sinara-hw/VHF_Amp/Project Outputs for VHF_AMP/Report Board Stack/VHF_AMP.xls

Board Stack Report
Stack Up |  | Layer Stack
Layer | Board Layer Stack | Name | Material | Thickness | Constant
1 |  | TopPaste
2 |  | Top Overlay
3 |  | Top Solder | SM-001 | 1,00mil | 4
4 |  | Top Layer | Copper | 1,38mil
5 |  | Dielectric 1 | PP-017 | 7,09mil | 4,3
6 |  | Dielectric 2 | PP-017 | 7,09mil | 4,3
7 |  | Int1 (GND) | Copper | 1,38mil
8 |  | Dielectric 3 | Core-039 | 27,95mil | 4,8
9 |  | Int2 (PWR) | Copper | 1,38mil
10 |  | Dielectric 4 | PP-017 | 7,09mil | 4,3
11 |  | Dielectric 5 | PP-017 | 7,09mil | 4,3
12 |  | Bottom Layer | Copper | 1,38mil
13 |  | Bottom Solder | SM-001 | 1,00mil | 4
14 |  | Bottom Overlay
15 |  | BottomPaste
 | Height : 63,81mil
