sinara-hw/VHF_Amp/Project Outputs for VHF_AMP/BOM/Bill of Materials-VHF_AMP(std).xlsx

Comment | Description | Designator | Footprint | Manufacturer | Manufacturer Part Number | Manufacturer1 ComponentHeight | Manufacturer1 Example | Manufacturer1 Part Number | Part Description | Part Number | Quantity
22nF | Non-polarised capacitor | C1, C72 | CAPC2012X135N | GENERIC | CC0805_22NF_50V_10%_X7R | 1.35mm | PHYCOMP | 223858615641 | SMD Multilayer Chip Ceramic Capacitor | CC0805_22NF_50V_10%_X7R | 2
10uF | Non-polarised capacitor | C2, C11, C12, C26, C27, C29, C42, C63 | CAPC3216X140N | GENERIC | CC1206_10UF_10V_10%_X7R | 1.8mm | KEMET | C1206C106K8RAC | SMD Multilayer Chip Ceramic Capacitor | CC1206_10UF_10V_10%_X7R | 8
10nF | Non-polarised capacitor | C3, C15, C18, C30, C40, C41, C53_VHF_FWD_RFD, C53_VHF_REV_RFD | CAPC1005X55N | GENERIC | CC0402_10NF_16V_10%_X7R, CC0402_10NF_25V_10%_X7R | 0.55mm | PHYCOMP, TDK | 223878715636, C1005X7R1E103KT | SMD Multilayer Chip Ceramic Capacitor | CC0402_10NF_16V_10%_X7R, CC0402_10NF_25V_10%_X7R | 8
100nF | Non-polarised capacitor | C4, C44, C47, C66, C73, C84 | CAPC3216X140N | GENERIC | CC1206_100NF_100V_10%_X7R | 1.25mm | PHYCOMP | 222260115649 | SMD Multilayer Chip Ceramic Capacitor | CC1206_100NF_100V_10%_X7R | 6
10nF | Non-polarised capacitor | C5, C6, C7, C9, C93, C95, C96, C100, C155, C156, C157, C159 | CAPC1608X87N | GENERIC | CC0603_10NF_50V_10%_X7R | 0.87mm | PHYCOMP | 223858615636 | SMD Multilayer Chip Ceramic Capacitor | CC0603_10NF_50V_10%_X7R | 12
220pF | Non-polarised capacitor | C8, C39, C74, C78 | CAPC2012X135N | GENERIC | CC0805_220PF_50V_5%_C0G | 0.88mm | KEMET | C0805C151J5GACTU | SMD Multilayer Chip Ceramic Capacitor | CC0805_220PF_50V_5%_C0G | 4
100nF | Non-polarised capacitor | C10, C25, C32, C34, C36, C55_VHF_FWD_RFD, C55_VHF_REV_RFD, C56_VHF_FWD_RFD, C56_VHF_REV_RFD, C57_VHF_FWD_RFD, C57_VHF_REV_RFD, C58_VHF_FWD_RFD, C58_VHF_REV_RFD, C60_VHF_FWD_RFD, C60_VHF_REV_RFD, C61_VHF_FWD_RFD, C61_VHF_REV_RFD, C62, C64, C65, C67, C89, C108, C110, C139, C141, C142, C150, C152, C153, C161, C162, C245_VHF_FWD_RFD, C245_VHF_REV_RFD | CAPC1005X55N | GENERIC | CC0402_100NF_16V_10%_X5R, CC0402_100NF_50V_10%_X7R | 0.55mm | MURATA | GRM155R61C104KA88D, GRM155R71H104KE14D | SMD Multilayer Chip Ceramic Capacitor | CC0402_100NF_16V_10%_X5R, CC0402_100NF_50V_10%_X7R | 34
22uF | Non-polarised capacitor | C13, C14 | CAPC3225X140N | GENERIC | CC1210_22UF_25V_20%_X7R | 1.4mm | KEMET | C1210C226M3RACTU | SMD Multilayer Chip Ceramic Capacitor | CC1210_22UF_25V_20%_X7R | 2
220pF | Non-polarised capacitor | C16, C17, C20, C21 | CAPC1005X55N | GENERIC | CC0402_220PF_50V_5%_C0G | 0.55mm | KEMET | C0402C221J5GACTU | SMD Multilayer Chip Ceramic Capacitor | CC0402_220PF_50V_5%_C0G | 4
0.5pF | Non-polarised capacitor | C19 | CAPC1005X50N | AVX | 04023J0R5ABSTR |  |  |  | Thin-Film Chip Capacitor for RF Signal and Power Applications, Accu-P Series | CC0402_0.5PF_25V_0.05PF_AVX_04023J0R5ABSTR | 1
100nF | Non-polarised capacitor | C22 | CAPC1608X87N | GENERIC | CC0603_100NF_50V_10%_X7R | 0.87mm | PHYCOMP | 223858615649 | SMD Multilayer Chip Ceramic Capacitor | CC0603_100NF_50V_10%_X7R | 1
10uF | Non-polarised capacitor | C23, C24 | CAPC3225X270N | GENERIC | CC1210_10UF_25V_10%_X7R | 2.7mm | KEMET | C1210C106K4RACTU | SMD Multilayer Chip Ceramic Capacitor | CC1210_10UF_25V_10%_X7R | 2
1uF | Non-polarised capacitor | C28, C68, C77, C97, C101, C112, C113, C135, C137 | CAPC1608X87N | GENERIC | CC0603_1UF_16V_10%_X7R, CC0603_1UF_25V_10%_X7R | 0.9mm | YAGEO PHYCOMP, MURATA | 223878615663, GRM188R71E105KA12D | SMD Multilayer Chip Ceramic Capacitor | CC0603_1UF_16V_10%_X7R, CC0603_1UF_25V_10%_X7R | 9
10uF | Non-polarised capacitor | C31, C48, C70, C91, C92, C94, C115, C116, C117, C123, C124, C125, C126, C127, C128, C145, C146, C147, C148 | CAPC_TDK_CKG45N | TDK | CKG45NX7S2A106M500JH |  |  |  | Multilayer Ceramic Chip Capacitor - Stacked Cap, CKG45N Series | CC1812_10UF_100V_20%_X7S_TDK_CKG45N | 19
22uF | Non-polarised capacitor | C33, C35, C37, C38, C107, C114, C138, C149 | CAPC3216X180N | TDK | C3216JB1V226M160AC |  |  |  | SMD Multilayer Chip Ceramic Capacitor | CC1206_22UF_35V_20%_JB_TDK_C3216JB1V226M160AC | 8
1nF | Non-polarised capacitor | C43, C46, C50, C83, C86, C87, C98 | CAPC2012X135N | GENERIC | CC0805_1NF_50V_5%_C0G | 0.88mm | KEMET | C0805C102J5GACTU | SMD Multilayer Chip Ceramic Capacitor | CC0805_1NF_50V_5%_C0G | 7
10uF | Non-polarised capacitor | C45, C85 | CAPC3225X280N | TAIYO YUDEN | UMK325AB7106KMHP |  |  |  | SMD Multilayer Chip Ceramic Capacitor (High Dielectric Type) for Automotive / Industrial Applications | CC1210_10UF_50V_10%_X7R_YUDEN_UMK325AB7106KMHP | 2
100nF | Non-polarised capacitor | C49, C71, C88 | CAPC2012X135N | GENERIC | CC0805_100NF_50V_10%_X7R | 1mm | TDK | C2012X7R1H104K085AA | SMD Multilayer Chip Ceramic Capacitor | CC0805_100NF_50V_10%_X7R | 3
100pF | Non-polarised capacitor | C51_VHF_FWD_RFD, C51_VHF_REV_RFD, C59_VHF_FWD_RFD, C59_VHF_REV_RFD | CAPC1005X55N | GENERIC | CC0402_100PF_50V_5%_C0G | 0.55mm | KEMET | C0402C101J5GACTU | SMD Multilayer Chip Ceramic Capacitor | CC0402_100PF_50V_5%_C0G | 4
2.2nF | Non-polarised capacitor | C52_VHF_FWD_RFD, C52_VHF_REV_RFD | CAPC1608X87N | GENERIC | CC0603_2.2NF_50V_5%_C0G | 0.9mm | TDK | C1608C0G1H222J080AA | SMD Multilayer Chip Ceramic Capacitor | CC0603_2.2NF_50V_5%_C0G | 2
1nF | Non-polarised capacitor | C54_VHF_FWD_RFD, C54_VHF_REV_RFD | CAPC1005X55N | GENERIC | CC0402_1NF_50V_10%_X7R | 0.55mm | PHYCOMP | 223858715623 | SMD Multilayer Chip Ceramic Capacitor | CC0402_1NF_50V_10%_X7R | 2
1uF | Non-polarised capacitor | C69, C75, C76, C82, C99, C103, C105, C106, C109, C134, C140, C143, C144, C151 | CAPC1005X55N | GENERIC | CC0402_1UF_16V_10%_X5R | 0.55mm | TDK | C1005X5R1C105KT | SMD Multilayer Chip Ceramic Capacitor | CC0402_1UF_16V_10%_X5R | 14
10uF | Non-polarised capacitor | C79, C80, C81 | CAPC2012X95N | GENERIC | CC0805_10UF_25V_10%_X5R | 0.95mm | MURATA | GRM219R61E106KA12D | SMD Multilayer Chip Ceramic Capacitor | CC0805_10UF_25V_10%_X5R | 3
4.7uF | Non-polarised capacitor | C90 | CAPC1709X95N | GENERIC | CC0603_4.7UF_16V_10%_X5R | 0.95mm | TAIYO YUDEN | EMK107ABJ475KA-T | SMD Multilayer Chip Ceramic Capacitor | CC0603_4.7UF_16V_10%_X5R | 1
4.7uF | Polarised capacitor | C102 | CAPMP3216X180N | AVX | TPSA475K010T1400 |  |  |  | Low ESR 1R4 Automotive Solid Tantalum Chip Capacitor | CTE3216-18_4.7UF_10V_10%_AVX_TPSA475K010T1400 | 1
Undefined | Non-polarised capacitor | C111, C122, C133, C136 | CAPC1608X90N | Undefined | CC0603_NO-VALUE | 0.9mm |  |  | Reserved Footprint For 0603(1608) Chip Ceramic Capacitor | CC0603_NO-VALUE | 4
2.2uF | Non-polarised capacitor | C118, C119, C120, C121, C129, C130, C131, C132 | CAPC3216X180N | GENERIC | CC1206_2.2uF_50V_10%_X7R | 1.8mm | KEMET | C1206C225K5RACTU | SMD Multilayer Chip Ceramic Capacitor | CC1206_2.2UF_50V_10%_X7R | 8
1uF | Non-polarised capacitor | C154 | CAPC2012X110N | GENERIC | CC0805_1UF_50V_10%_X7R | 1.1mm | KEMET | C0805C105K5RACTU | SMD Multilayer Chip Ceramic Capacitor | CC0805_1UF_50V_10%_X7R | 1
Undefined | Non-polarised capacitor | C158, C160 | CAPC2012X135N | Undefined | CC0805_NO-VALUE | 1.35mm |  |  | Reserved Footprint For 0805(2012) Chip Ceramic Capacitor | CC0805_NO-VALUE | 2
SMBJ12A | Zener Diode | D1 | DIOM5336X265N | FAIRCHILD SEMICONDUCTOR | SMBJ12A |  |  |  | Uni-Directional Transient Voltage Suppressor Diode | SMBJ12A | 1
BAT165 | Schottky Diode | D2 | SOD2512X110N | INFINEON | BAT165 |  |  |  | Medium Power AF Schottky Diode | BAT165 | 1
PESD3V3S4UD | Quad Common Anode ESD Protection Diodes (30kV) | D3, D4 | SOT95P280X110-6N | NXP SEMICONDUCTORS | PESD3V3S4UD |  |  |  | Quad Common Anode ESD Protection Diodes (30kV) | PESD3V3S4UD | 2
PRTR5V0U2X | Ultra Low Capacitance Double Rail-to-Rail ESD Protection Diode | D6 | SOT190P230X110-4N | NXP SEMICONDUCTORS | PRTR5V0U2X |  |  |  | Ultra Low Capacitance (1pF) Double Rail-to-Rail ESD Protection Diode (8kV) | PRTR5V0U2X | 1
PMEG6020ER | Schottky Diode | D8 | SODFL3517X110N | NXP SEMICONDUCTORS | PMEG6020ER |  |  |  | MEGA Schottky Barrier Rectifier | PMEG6020ER | 1
220R@100MHz |  | FB2_VHF_FWD_RFD, FB2_VHF_REV_RFD | INDC1005X55N | MURATA | BLM15HB221SN1 |  |  |  | SMD EMIFIL Suppression Chip Ferrite Bead | IND0402_MURATA_BLM15HB221SN1 | 2
10A/50VDC | Block Type EMIFIL (LC Combined) | FL1 | FIL_MURATA_BNX02 | MURATA | BNX022-01L |  |  |  | Block Type EMIFIL (LC Combined) SMD Type, BNX02* Series | FIL_MURATA_BNX022-01L | 1
MERA-7456 | Dual Differential Inputs and Complementary TTL outputs | IC1 | MINI-CIRCUITS_DL1020 | MINI-CIRCUITS | MERA-7456 |  |  |  | DC-1GHz, Dual Matched MMIC Amplifier | MERA-7456 | 1
FIN1028MX | 3.3V LVDS 2-Bit High-Speed Differential Reciever | IC2, IC13, IC15 | SOIC127P600X175-8N | ON Semiconductor | FIN1028MX |  |  |  | 3.3V LVDS 2-Bit High-Speed Differential Reciever | FIN1028MX | 3
LT1963EQ#PBF | 1.5A, Fast Transient Response Adjustable LDO Regulators | IC3 | TO170P1394X457-6N-R900X1060 | LINEAR TECHNOLOGY | LT1963EQ#PBF |  |  |  | 1.5A, 1.21V to 20V, Fast Transient Response, Adjustable LDO Regulator | LT1963EQ#PBF | 1
FIN1027AMX | 3.3V LVDS, 2-Bit, High-Speed, Differential Driver | IC4 | SOIC127P600X175-8N | ON Semiconductor | FIN1027AMX |  |  |  | 3.3V LVDS, 2-Bit, High-Speed, Differential Driver | FIN1027AMX | 1
TPS62148RGX | 3V-17V 2A Step-Down Converter, High Accuracy, With DCS-Control | IC5 | TEXAS_RGX0011A | TEXAS INSTRUMENTS | TPS62148RGX |  |  |  | 3V-17V 2A Step-Down Converter, High Accuracy, With DCS-Control | TPS62148RGX | 1
TPS7A4700RGWT | Low Noise (3uVrms), 1A, High Voltage Low-Dropout Linear Regulator | IC6, IC25 | QFN65P500X500X100-21N-S325 | TEXAS INSTRUMENTS | TPS7A4700RGW |  |  |  | 1.4V to 19.1V, 1A, Low Noise (3.5uVrms), Low-Dropout Linear Regulator | TPS7A4700RGWT | 2
MPGA-152 | Dual Differential Inputs and Complementary TTL outputs | IC7 | QFN50P400X400X100-25N-S265 | MINI-CIRCUITS | MPGA-152 |  |  |  | 30GHz to 1500MHz, 50 Ohm, Low Noise, High IP3, Monolithic Amplifier | MPGA-152 | 1
MAX1329BETL+ | 12-/16-Bit DAS with ADC, DACs, DPIOs, APIOs, Reference, Voltage Monitors, and Temp Sensor | IC8, IC19 | QFN50P600X600X80-41N-S425 | MAXIM | MAX1329BETL |  |  |  | 12-/16-Bit DAS with ADC, DACs, DPIOs, APIOs, Reference, Voltage Monitors, and Temp Sensor | MAX1329BETL+ | 2
ADL5904ACPZN-R7 | DC to 6 GHz, 45 dB TruPwr Detector With Envelope Threshold Detection | IC9_VHF_FWD_RFD, IC9_VHF_REV_RFD | QFN50P300X300X80-17N-S175 | ANALOG DEVICES | ADL5904ACPZN-R7 |  |  |  | DC to 6 GHz, 45 dB TruPwr Detector With Envelope Threshold Detection | ADL5904ACPZN-R7 | 2
ADCMP600BRJZ-R2 | Rail-to-Rail, Very Fast, 2.5 V to 5.5 V Single-Supply TTL/CMOS Comparator | IC10_VHF_FWD_RFD, IC10_VHF_REV_RFD | SOT95P280X145-5N | ANALOG DEVICES | ADCMP600BRJZ-R2 |  |  |  | Rail-to-Rail, Very Fast, 2.5 V to 5.5 V Single-Supply TTL/CMOS Comparator | ADCMP600BRJZ-R2 | 2
SN74LVC112APWR | Dual Negative-Edge-Triggered J-K Flip-Flop With Clear And Preset | IC11_VHF_FWD_RFD, IC11_VHF_REV_RFD | SOP65P640X120-16N | TEXAS INSTRUMENTS | SN74LVC112APWR |  |  |  | Dual Negative-Edge-Triggered J-K Flip-Flops With Clear and Preset | SN74LVC112APWR | 2
MCP6291T-E/OT | Operational Amplifier | IC12_VHF_FWD_RFD, IC12_VHF_REV_RFD, IC17_VHF_FWD_RFD, IC17_VHF_REV_RFD | SOT95P270X145-5N | MICROCHIP TECHNOLOGY | MCP6291T-E/OT |  |  |  | 1.0mA, 10 MHz Rail-to-Rail Operational Amplifier | MCP6291T-E/OT | 4
74HC4066PW |  | IC14, IC32 | SOP65P640X110-14N | NXP SEMICONDUCTORS | 74HC4066PW |  |  |  | Quad Single-Pole Single-Throw Analog Switch | 74HC4066PW | 2
24AA02E48T-I/OT | 1.7V-5.5V, 2K I2C Serial EEPROM With EUI-48 Node Identity | IC16 | SOT95P280X145-5N | MICROCHIP TECHNOLOGY | 24AA02E48T-I/OT |  |  |  | 1.7V-5.5V, 2K I2C Serial EEPROM With EUI-48 Node Identity | 24AA02E48T-I/OT | 1
JSW2-63DR+ | SPDT RF Switch, 50 Ohm, 5 to 6000MHz, High Power 3W | IC18 | MINI-CIRCUITS_MT1818 | MINI-CIRCUITS | JSW2-63DR+ |  |  |  | SPDT RF Switch, 50 Ohms, 5 to 6000MHz, High Power 3W | JSW2-63DR+ | 1
AD8397ARDZ | Dual Operational Amplifier With Exposed Pad | IC20, IC23 | SOIC127P600X175-9N-R241X309 | ANALOG DEVICES | AD8397ARDZ |  |  |  | Rail-to-Rail, High Output Current Amplifier | AD8397ARDZ | 2
LTM8056IY#PBF | 58VIN, 48VOUT Buck-Boost µModule Regulator | IC21, IC22 | BGA121C127P11X11_1500X1500X512 | LINEAR TECHNOLOGY | LTM8056IY#PBF |  |  |  | 58VIN, 48VOUT Buck-Boost µModule Regulator | LTM8056IY#PBF | 2
SN74LVC1G32DBVR | Single 2-Input Positive-OR Gate | IC24_VHF_FWD_RFD, IC24_VHF_REV_RFD | SOT95P280X145-5N | TEXAS INSTRUMENTS | SN74LVC1G32DBVR |  |  |  | Single 2-Input Positive-OR Gate | SN74LVC1G32DBVR | 2
LM75AIMM/NOPB | Digital Temperature Sensor and Thermal Watchdog with Two-Wire Interface | IC26, IC27 | SOP65P490X109-8N | TEXAS INSTRUMENTS | LM75AIMM/NOPB |  |  |  | -25° to +100°C ±2°C Digital Temperature Sensor and Thermal Watchdog with Two-Wire Interface | LM75AIMM/NOPB | 2
MAX6033AAUT25#TG16 | Ultra-High-Precision Voltage References | IC28 | SOT95P280X145-6N | MAXIM | MAX6033AAUT25#TG16 |  |  |  | 2.5V, 15mA, Ultra-High-Precision Voltage References | MAX6033AAUT25#TG16 | 1
74LVC1GU04GW | Single Inverter Buffer | IC29, IC38 | SOT65P212X110-5N | NXP SEMICONDUCTORS | 74LVC1GU04GW |  |  |  | Inverter | 74LVC1GU04GW | 2
LD1117DT33CTR | 3-Terminal Regulator 1=GND 2=IN 3=OUT | IC30, IC31 | TO228P972X240-3N-R540X510 | ST MICROELECTRONICS | LD1117DT33CTR |  |  |  | 3.3V 800mA Low drop fixed and adjustable positive voltage regulators | LD1117DT33CTR | 2
MIC5219-3.3YM5 | 500mA Peak Output LDO Regulator | IC33 | SOT95P280X145-5N | MICROCHIP TECHNOLOGY | MIC5219-3.3YM5 |  |  |  | 3.3V 500mA Peak Output Low Drop-Out (LDO) Regulator | MIC5219-3.3YM5 | 1
SYDC-20-62HP+ | 50Ohm, 10 to 540MHz, 25W, 20dB Bi-Directional Coupler | IC34 | MINI-CIRCUITS_AH202-1 | MINI-CIRCUITS | SYDC-20-62HP+ |  |  |  | 50Ohm, 10 to 540MHz, 25W, 20dB Bi-Directional Coupler | SYDC-20-62HP+ | 1
TLC555ID | LinCMOS Timer | IC35 | SOIC127P600X175-8N | TEXAS INSTRUMENTS | TLC555ID |  |  |  | LinCMOS Timer | TLC555ID | 1
INA286AQDRQ1 | 80V, Bi-Directional, Low-/High-Side, Voltage Output Current Sense Amplifier | IC36, IC37 | SOIC127P600X175-8N | TEXAS INSTRUMENTS | INA286AQDRQ1 |  |  |  | 80V, Bi-Directional, Low-/High-Side, Voltage Output Current Sense Amplifier (Automotive Grade) | INA286AQDRQ1 | 2
SMA | 50 Ohm Through Hole SMA Right Angle PCB Jack | J1, J2 | DELOCK_65848 | DELOCK | 5848 (4043619658480) |  |  |  | 50 Ohm Through Hole SMA Right Angle PCB Jack | DELOCK_65848 | 2
MCX |  | J3 | AMPHENOL_919-383J-51A | AMPHENOL | 919-383J-51A |  |  |  | 50 Ohm, RF Connector, MCX Right Angle PCB Receptacle Jack | AMPHENOL_919-383J-51A | 1
Mini-Fit Jr.™ | Connector 4 Male | J7 | MOLEX_39-30-0040 | MOLEX | 39-30-0040 |  |  |  | 4.20mm (.165") Pitch Mini-Fit Jr. Header, Dual Row, Right Angle with Snap-in Plastic Peg PCB Lock, 4 Circuits | MOLEX_39-30-0040 | 1
Jack | 2.5 mm Center Pin, 5A, 48V, Right Angle, Through Hole, , DC Power Jack Connector | J8 | SWITCHCRAFT_712RA | SWITCHCRAFT | 712RA |  |  |  | 2.5 mm Center Pin, 5A, 48VDC, Right Angle, Through Hole, Locking Power Jack Connector (Threaded Bushings) | SWITCHCRAFT_712RA | 1
 | Connector 30 Male | J9 | 3M_N2530-6002RB | 3M | N2530-6002RB |  |  |  | 30 Contacts - Straight .100'' x .100'' Low Profile Four-Wall Header, 2500 Series | 3M_N2530-6002RB | 1
KK® | Connector 2 Male | J11 | MOLEX_22-04-1021 | MOLEX | 22-04-1021 |  |  |  | 2.5mm (.100") Pitch KK® Wire-to-Board Header, Vertical, with Friction Lock, 2 Circuits, Tin (Sn) Plating | MOLEX_22-04-1021 | 1
P1 | 72 Contacts Header, 6 Columns, 4 Pairs per Column | J13 | AMPHENOL_10052825-101LF | AMPHENOL | 10052825-101LF |  |  |  | 72 Contacts, 2mm Pitch, 6 Columns, 4 Pairs per Column, 4 Walls, Right Angle Header | AMPHENOL_10052825-101LF | 1
120R@100MHz |  | L1, L12 | INDC1005X55N | MURATA | BLM15PX121SN1D |  |  |  | SMD EMIFIL Chip Ferrite Bead | IND0402_MURATA_BLM15PX121SN1D | 2
390nH@100MHz | Inductor | L2, L3, L4, L5 | IND_COILCRAFT_0805HP | COILCRAFT | 0805HP-391XGR |  |  |  | Chip Inductor | IND0805_COILCRAFT_0805HP-391XGR | 4
1000R@100MHz |  | L6 | INDC1608X95N | MURATA | BLM18HE102SN1 |  |  |  | SMD EMIFIL Suppression Chip Ferrite Bead | IND0603_MURATA_BLM18HE102SN1 | 1
1uH | Inductor | L7, L11 | INDC2620X100N | WURTH ELEKTRONIK | 74479787210B |  |  |  | Power Multilayer Inductor (WE-PMI Series) | IND1008_1UH_20%_WURTH_74479787210B | 2
1.5uH | Inductor With Core | L8, L9, L10 | IND_TDK_SPM6530 | TDK | SPM6530T-1R5M100 |  |  |  | SMD Inductor for Power Circuits (Wound Metal), SPM Series | IND_1.5UH_20%_TDK_SPM6530 | 3
100nH | Inductor | L13, L14 | IND_COILCRAFT_1812SMS | COILCRAFT | 1812SMS-R10JLC |  |  |  | SMD Midi Spring Air Core Inductor | IND_100NH_5%_COILCRAFT_1812SMS-R10JLC | 2
1uH | Inductor | L15, L16 | IND_BOURNS_SRN3015 | BOURNS | SRN3015-1R0Y |  |  |  | Semi-Shielded SMD Power Inductor | IND_1UH_30%_BOURNS_SRN3015 | 2
Green | LED Green 1C 2A | LD1, LD2, LD3, LD4, LD5, LD6, LD7, LD8_VHF_FWD_RFD, LD8_VHF_REV_RFD, LD9, LD11 | LED_KINGBRIGHT_KPH-1608CGCK | KINGBRIGHT | KPH-1608CGCK |  |  |  | SMD Green LED, Case 1.6mmX0.8mm(0603), 0.65mm Thickness | LED_KINGBRIGHT_KPH-1608CGCK | 11
Red | LED Red 1C 2A | LD10 | LED_AVAGO_HSMC-C120 | AVAGO TECHNOLOGIES | HSMC-C120 |  |  |  | High Performance Right Angle Chip Red LED | LED_AVAGO_HSMC-C120 | 1
10k | Trimming Potentiometer | P1, P2 | TRIM_BOURNS_3224W | BOURNS | 3224W-1-103E |  |  |  | 12 Turns SMD Trimpot® Trimming Potentiometer (Top Adjust) | TRIM_12T_10K_BOURNS_3224W-1-103E | 2
Switch | Push-Button Switch SPDT | PB1, PB2 | SW_C&K_PCM12SMTR | C&K | PCM12SMTR |  |  |  | SPDT, Right Angled Ultraminiature Surface Mount Slide Switches, C&K PCM Series | SW_C&K_PCM12SMTR | 2
Push Button | Push-Button Switch SPDT | PB3 | PB_TYCO_1-1825027-1 | TYCO ELECTRONICS | 1-1825027-1 |  |  |  | Right Angle Micro Miniature Tactile Pushbutton Switch, Round Actuator Length = 5.74mm, FSMRAJ Series | PB_TYCO_1-1825027-1 | 1
51 | Resistor - 1% | R1, R2 | RESC5025X70N | BOURNS | CRM2010-FX-51R0ELF |  |  |  | Power Thick Film Chip Resistor | R2010_51R_1%_1W_100PPM_BOURNS_CRM | 2
0 | Resistor | R3, R4, R5, R6, R7, R8, R9, R24_VHF_FWD_RFD, R24_VHF_REV_RFD, R92, R105, R151, R154, R235, R236, R241, R242, R243, R247, R248 | RESC1005X40N | GENERIC | R0402_0R_JUMPER | 0.4mm | YAGEO PHYCOMP | 232270591001L | 1A (0.05R Max DC Resistance) Zero Ohm Jumper | R0402_0R_JUMPER | 20
330 | Resistor - 1% | R10, R15 | RESC2012X60N | GENERIC | R0805_330R_1%_0.125W_100PPM | 0.6mm | NIC COMPONENT | NRC10F3300TRF | General Purpose Thick Film Chip Resistor | R0805_330R_1%_0.125W_100PPM | 2
2R7 | Resistor - 1% | R11, R18 | RESC2012X60N | GENERIC | R0805_2R7_1%_0.125W_200PPM | 0.65mm | YAGEO PHYCOMP | 232273462708L or RC0805FR-072R7L | General Purpose Thick Film Chip Resistor | R0805_2R7_1%_0.125W_200PPM | 2
9R1 | Resistor - 1% | R12, R19 | RESC2012X60N | GENERIC | R0805_9R1_1%_0.125W_200PPM | 0.65mm | YAGEO PHYCOMP | 232273469108L or RC0805FR-079R1L | General Purpose Thick Film Chip Resistor | R0805_9R1_1%_0.125W_200PPM | 2
22 | Resistor - 1% | R13, R20 | RESC2012X60N | GENERIC | R0805_22R_1%_0.125W_100PPM | 0.6mm | NIC COMPONENT | NRC10F22R0TRF | General Purpose Thick Film Chip Resistor | R0805_22R_1%_0.125W_100PPM | 2
33 | Resistor - 1% | R14, R21 | RESC2012X60N | GENERIC | R0805_33R_1%_0.125W_100PPM | 0.6mm | NIC COMPONENT | NRC10F33R0TRF | General Purpose Thick Film Chip Resistor | R0805_33R_1%_0.125W_100PPM | 2
100 | Resistor - 1% | R16, R34, R35, R36, R37, R38, R39, R44, R45, R62, R80, R82, R158, R169 | RESC1005X40N | GENERIC | R0402_100R_1%_0.0625W_100PPM | 0.4mm | YAGEO PHYCOMP | 232270671001L | General Purpose Thick Film Chip Resistor | R0402_100R_1%_0.0625W_100PPM | 14
47k | Resistor - 1% | R17 | RESC1608X55N | GENERIC | R0603_47K_1%_0.1W_100PPM | 0.55mm | NIC COMPONENT | NRC06F4702TRF | General Purpose Thick Film Chip Resistor | R0603_47K_1%_0.1W_100PPM | 1
0 | Resistor | R22_VHF_FWD_RFD, R22_VHF_REV_RFD, R25_VHF_FWD_RFD, R25_VHF_REV_RFD, R40, R41, R48, R49, R66, R71, R76, R83, R84, R96, R99, R114, R115, R116, R117, R118, R119, R126, R129, R130, R131, R132, R133, R135, R136, R157, R159, R160, R164, R167, R168, R182, R183 | RESC1608X55N | GENERIC | R0603_0R_JUMPER | 0.55mm | NIC COMPONENT | NRC06Z0 | 1A (0.05R Max DC Resistance) Zero Ohm Jumper | R0603_0R_JUMPER | 37
1k | Resistor - 1% | R23_VHF_FWD_RFD, R23_VHF_REV_RFD, R47, R156, R161, R162, R170, R172, R173, R174, R175, R176, R177, R181 | RESC1005X40N | GENERIC | R0402_1K_1%_0.0625W_100PPM | 0.4mm | YAGEO PHYCOMP | 232270671002L | General Purpose Thick Film Chip Resistor | R0402_1K_1%_0.0625W_100PPM | 14
22k | Resistor - 1% | R26, R58, R60 | RESC1005X40N | GENERIC | R0402_22K_1%_0.0625W_100PPM | 0.4mm | YAGEO PHYCOMP | 232270672203L | General Purpose Thick Film Chip Resistor | R0402_22K_1%_0.0625W_100PPM | 3
82 | Resistor - 1% | R27_VHF_FWD_RFD, R27_VHF_REV_RFD | RESC1608X55N | GENERIC | R0603_82R_1%_0.1W_100PPM | 0.55mm | NIC COMPONENT | NRC06F82R0TRF | General Purpose Thick Film Chip Resistor | R0603_82R_1%_0.1W_100PPM | 2
56k | Resistor - 1% | R28 | RESC1608X55N | GENERIC | R0603_56K_1%_0.1W_100PPM | 0.55mm | NIC COMPONENT | NRC06F5602TRF | General Purpose Thick Film Chip Resistor | R0603_56K_1%_0.1W_100PPM | 1
1 | Resistor - 1% | R29, R63 | RESC1005X40N | GENERIC | R0402_1R_1%_0.0625W_200PPM | 0.4mm | YAGEO PHYCOMP | 232270671008L | General Purpose Thick Film Chip Resistor | R0402_1R_1%_0.0625W_200PPM | 2
8k2 | Resistor - 1% | R30 | RESC1608X55N | GENERIC | R0603_8K2_1%_0.1W_100PPM | 0.55mm | NIC COMPONENT | NRC06F8201TRF | General Purpose Thick Film Chip Resistor | R0603_8K2_1%_0.1W_100PPM | 1
3R9 | Resistor - 1% | R31_VHF_FWD_RFD, R31_VHF_REV_RFD | RESC1005X40N | GENERIC | R0402_3R9_1%_0.0625W_200PPM | 0.4mm | YAGEO PHYCOMP | 232270673908L | General Purpose Thick Film Chip Resistor | R0402_3R9_1%_0.0625W_200PPM | 2
10k | Resistor - 1% | R32_VHF_FWD_RFD, R32_VHF_REV_RFD, R46, R61, R72, R145, R148, R149, R153, R155, R171, R179, R218 | RESC1005X40N | GENERIC | R0402_10K_1%_0.0625W_100PPM, R0402_1K_1%_0.0625W_100PPM | 0.4mm | YAGEO PHYCOMP | 232270671003L, 232270671002L | General Purpose Thick Film Chip Resistor | R0402_10K_1%_0.0625W_100PPM, R0402_1K_1%_0.0625W_100PPM | 13
20k | Resistor - 1% | R33_VHF_FWD_RFD, R33_VHF_REV_RFD | RESC1005X40N | GENERIC | R0402_20K_1%_0.0625W_100PPM | 0.4mm | YAGEO PHYCOMP | 232270672003L | General Purpose Thick Film Chip Resistor | R0402_20K_1%_0.0625W_100PPM | 2
64k9 | Resistor - 0.1% | R42 | RESC1608X55N | GENERIC | R0603_64K9_0.1%_0.063W_10PPM | 0.5mm | TYCO HOLSWORTHY | RN73C1J64K9BTDF | Thin Film Chip Resistor | R0603_64K9_0.1%_0.063W_10PPM | 1
100k | Resistor - 1% | R43, R51 | RESC1608X55N | GENERIC | R0603_100K_1%_0.1W_100PPM | 0.55mm | NIC COMPONENT | NRC06F1003TRF | General Purpose Thick Film Chip Resistor | R0603_100K_1%_0.1W_100PPM | 2
47k | Resistor - 1% | R50, R59, R180 | RESC1005X40N | GENERIC | R0402_47K_1%_0.0625W_100PPM | 0.4mm | YAGEO PHYCOMP | 232270675103L | General Purpose Thick Film Chip Resistor | R0402_47K_1%_0.0625W_100PPM | 3
82 | Resistor - 1% | R52_VHF_FWD_RFD, R52_VHF_REV_RFD | RESC1005X40N | GENERIC | R0402_82R_1%_0.0625W_100PPM | 0.4mm | YAGEO PHYCOMP | 232270678209L | General Purpose Thick Film Chip Resistor | R0402_82R_1%_0.0625W_100PPM | 2
12k | Resistor - 1% | R53_VHF_FWD_RFD, R53_VHF_REV_RFD | RESC1005X40N | GENERIC | R0402_12K_1%_0.0625W_100PPM | 0.4mm | YAGEO PHYCOMP | 232270671203L | General Purpose Thick Film Chip Resistor | R0402_12K_1%_0.0625W_100PPM | 2
2k | Resistor - 1% | R54_VHF_FWD_RFD, R54_VHF_REV_RFD | RESC1005X40N | GENERIC | R0402_2K_1%_0.0625W_100PPM | 0.4mm | YAGEO PHYCOMP | 232270672002L | General Purpose Thick Film Chip Resistor | R0402_2K_1%_0.0625W_100PPM | 2
330 | Resistor - 1% | R55 | RESC1005X40N | GENERIC | R0402_330R_1%_0.0625W_100PPM | 0.4mm | YAGEO PHYCOMP | 232270673301L | General Purpose Thick Film Chip Resistor | R0402_330R_1%_0.0625W_100PPM | 1
100k | Resistor - 1% | R56 | RESC1005X40N | GENERIC | R0402_100K_1%_0.0625W_100PPM | 0.4mm | YAGEO PHYCOMP | 232270671004L | General Purpose Thick Film Chip Resistor | R0402_100K_1%_0.0625W_100PPM | 1
33k | Resistor - 1% | R57 | RESC1005X40N | GENERIC | R0402_33K_1%_0.0625W_100PPM | 0.4mm | YAGEO PHYCOMP | 232270673303L | General Purpose Thick Film Chip Resistor | R0402_33K_1%_0.0625W_100PPM | 1
0R01 | Resistor - 1% | R64, R65 | RESC3216X80N | TT Electronics | LRMAM1206-R01FT5 |  |  |  | Low Value Metal Alloy Resistor | R1206_0R01_1%_1W_100PPM_TT_LRMAM1206 | 2
200k | Resistor - 0.1% | R67, R77 | RESC1608X55N | GENERIC | R0603_200K_0.1%_0.063W_10PPM | 0.5mm | TYCO HOLSWORTHY | RN73C1J200KBTDF | Thin Film Chip Resistor | R0603_200K_0.1%_0.063W_10PPM | 2
18k | Resistor - 1% | R68 | RESC1005X40N | GENERIC | R0402_18K_1%_0.0625W_100PPM | 0.4mm | YAGEO PHYCOMP | 232270671803L | General Purpose Thick Film Chip Resistor | R0402_18K_1%_0.0625W_100PPM | 1
42k2 | Resistor - 0.1% | R69, R78 | RESC1608X55N | GENERIC | R0603_42K2_0.1%_0.063W_10PPM | 0.5mm | TYCO HOLSWORTHY | RN73C1J42K2BTDF | Thin Film Chip Resistor | R0603_42K2_0.1%_0.063W_10PPM | 2
6k98 | Resistor - 0.1% | R70 | RESC1608X55N | GENERIC | R0603_6K98_0.1%_0.063W_10PPM | 0.5mm | TYCO HOLSWORTHY | RN73C1J6K98BTDF | Thin Film Chip Resistor | R0603_6K98_0.1%_0.063W_10PPM | 1
Undefined | Resistor | R73, R74, R86, R87 | RESC1608X55N | Undefined | R0603_NO-VALUE | Undefined | Undefined | Undefined | Reserved Footprint For a 0603 (1608) Chip Resistor | R0603_NO-VALUE | 4
51 | Resistor - 0.1% | R75 | RESC1608X55N | GENERIC | R0603_51R_0.1%_0.063W_25PPM | 0.55mm | TE CONNECTIVITY | CPF0603B51RE1 | Thin Film Chip Resistor | R0603_51R_0.1%_0.063W_25PPM | 1
6k34 | Resistor - 0.1% | R79 | RESC1608X55N | GENERIC | R0603_6K34_0.1%_0.063W_10PPM | 0.5mm | TYCO HOLSWORTHY | RN73C1J6K34BTDF | Thin Film Chip Resistor | R0603_6K34_0.1%_0.063W_10PPM | 1
0 | Resistor | R81, R88, R89, R90, R93, R94, R100, R101, R104, R121, R122, R124, R125, R139, R163 | RESC2012X60N | GENERIC | R0805_0R_JUMPER | 0.6mm | NIC COMPONENT | NRC10Z0 | 2A (0.05R Max DC Resistance) Zero Ohm Jumper | R0805_0R_JUMPER | 15
200 | Resistor - 1% | R85 | RESC1608X55N | GENERIC | R0603_200R_1%_0.1W_100PPM | 0.55mm | NIC COMPONENT | NRC06F2000TRF | General Purpose Thick Film Chip Resistor | R0603_200R_1%_0.1W_100PPM | 1
4R7 | Resistor - 1% | R91 | RESC2012X60N | GENERIC | R0805_4R7_1%_0.125W_200PPM | 0.65mm | YAGEO PHYCOMP | 232273464708L or RC0805FR-074R7L | General Purpose Thick Film Chip Resistor | R0805_4R7_1%_0.125W_200PPM | 1
50 | Resistor - 1% | R95, R98, R138 | RESC1608X55N | GENERIC | R0603_50R_1%_0.1W_100PPM | 0.50mm | VISHAY | CRCW060350R0FKEA | General Purpose Thick Film Chip Resistor | R0603_50R_1%_0.1W_100PPM | 3
3k3 | Resistor - 1% | R97, R106, R216 | RESC1608X55N | GENERIC | R0603_3K3_1%_0.1W_100PPM | 0.55mm | NIC COMPONENT | NRC06F3301TRF | General Purpose Thick Film Chip Resistor | R0603_3K3_1%_0.1W_100PPM | 3
150 | Resistor - 0.1%, Resistor - 1% | R102, R103, R127, R137 | RESC1608X55N | GENERIC | R0603_150R_0.1%_0.063W_10PPM, R0603_150R_1%_0.1W_100PPM | 0.5mm, 0.55mm | TYCO HOLSWORTHY, NIC COMPONENT | RN73C1J150RBTDF, NRC06F1500TRF | Thin Film Chip Resistor, General Purpose Thick Film Chip Resistor | R0603_150R_0.1%_0.063W_10PPM, R0603_150R_1%_0.1W_100PPM | 4
4M7 | Resistor - 1% | R107, R128, R165, R166 | RESC2113X55N | VISHAY | CRCW08054M70FKEA |  |  |  | 150V, Standard Thick Film Chip Resistor | R0805_4M7_1%_0.125W_100PPM_VISHAY_CRCW e3 | 4
1k | Resistor - 1% | R108, R109, R110, R178_VHF_FWD_RFD, R178_VHF_REV_RFD | RESC1608X55N | GENERIC | R0603_1K_1%_0.1W_100PPM | 0.55mm | NIC COMPONENT | NRC06F1001TRF | General Purpose Thick Film Chip Resistor | R0603_1K_1%_0.1W_100PPM | 5
787 | Resistor - 0.1% | R111_VHF_FWD_RFD, R111_VHF_REV_RFD | RESC2012X60N | GENERIC | R0805_787R_0.1%_0.1W_10PPM | 0.6mm | TYCO HOLSWORTHY | RN73C2A787RBTG | Thin Film Chip Resistor | R0805_787R_0.1%_0.1W_10PPM | 2
53R6 | Resistor - 0.1% | R112_VHF_FWD_RFD, R112_VHF_REV_RFD, R113_VHF_FWD_RFD, R113_VHF_REV_RFD | RESC2012X60N | GENERIC | R0805_53R6_0.1%_0.1W_10PPM | 0.6mm | TYCO HOLSWORTHY | RN73C2A53R6BTG | Thin Film Chip Resistor | R0805_53R6_0.1%_0.1W_10PPM | 4
0R005 | Power and Current Sensing Resistor | R120, R123 | RES_OHMITE_LVK25 | OHMITE | LVK25R005DER |  |  |  | Four Terminal High Precision Current Sense | R_0R005_0.5%_2W_100PPM_OHMITE_LVK25 | 2
36 | Resistor - 1% | R134 | RESC1608X55N | GENERIC | R0603_36R_1%_0.1W_100PPM | 0.55mm | NIC COMPONENT | NRC06F36R0TRF | General Purpose Thick Film Chip Resistor | R0603_36R_1%_0.1W_100PPM | 1
22 | Resistor - 1% | R140, R141, R142, R143, R144 | RESC1005X40N | GENERIC | R0402_22R_1%_0.0625W_100PPM | 0.4mm | YAGEO PHYCOMP | 232270672209L | General Purpose Thick Film Chip Resistor | R0402_22R_1%_0.0625W_100PPM | 5
2k7 | Resistor - 1% | R146 | RESC1608X55N | GENERIC | R0603_2K7_1%_0.1W_100PPM | 0.55mm | YAGEO PHYCOMP | RC0603FR-072K7L | General Purpose Thick Film Chip Resistor | R0603_2K7_1%_0.1W_100PPM | 1
5k6 | Resistor - 1% | R147 | RESC1005X40N | GENERIC | R0402_5K6_1%_0.0625W_100PPM | 0.4mm | YAGEO PHYCOMP | 232270675602L | General Purpose Thick Film Chip Resistor | R0402_5K6_1%_0.0625W_100PPM | 1
1k6 | Resistor - 1% | R150, R152 | RESC1005X40N | GENERIC | R0402_1K6_1%_0.0625W_100PPM | 0.4mm | YAGEO PHYCOMP | 232270671602L | General Purpose Thick Film Chip Resistor | R0402_1K6_1%_0.0625W_100PPM | 2
100k | Thermistor NTC (Negative Temperature Coefficient) | RT1 | THERMC1608X95N | VISHAY | NTCS0603E3104FXT |  |  |  | SMD 0603, Glass Protected NTC Thermistor | THERM_NTC_100K_VISHAY_NTCS0603E3104FXT | 1
SCHROFF_PANEL_3U_4HP | Schroff 3HP 4U EUROCARD Panel Kit | ST1 | SCHROFF_PANEL_3HP_4U | Schroff | 20818-017 |  |  |  |  |  | 1
Trans Ideal | Transformer (Ideal) | T1 | Balun_5961000601 |  |  |  |  |  |  |  | 1
MRF101BN | N-CHANNEL MOSFET WITH DIODE | T2 | TO-220-HFLIP | NXP SEMICONDUCTORS | MRF101BN |  |  |  | 133V 115W NPN Silicon Plastic Power Transistor | MRF101BN_hflip | 1
MRF101AN | N-CHANNEL MOSFET WITH DIODE | T3 | TO-220-HFLIP | NXP SEMICONDUCTORS | MRF101AN |  |  |  | 133V 115W NPN Silicon Plastic Power Transistor | MRF101AN_hflip | 1
Trans Ideal | Transformer (Ideal) | T4 | Balun_5961000601_power |  |  |  |  |  |  |  | 1
Trans Ideal | Transformer (Ideal) | T5 | Balun_5943001101 |  |  |  |  |  |  |  | 1
SI4425DDY-T1-GE3 | -30V -19.7A P-Channel MOSFET | T6 | SOIC127P600X175-8N | VISHAY SILICONIX | SI4425DDY-T1-GE3 |  |  |  | -30V -19.7A P-Channel MOSFET | SI4425DDY-T1-GE3 | 1
BSS138LT1G | N-CHANNEL MOSFET WITH DIODE | T7, T14 | SOT95P240X110-3N | ON SEMICONDUCTOR | BSS138LT1G |  |  |  | 50V 200mA N-Channel Enhancement Mode Field-Effect Transistor | BSS138LT1G | 2
Test Point | Test Point | TP1, TP2, TP3, TP4, TP5, TP6, TP7, TP8_VHF_FWD_RFD, TP8_VHF_REV_RFD, TP10, TP11, TP12, TP16, TP18, TP20, TP21, TP22, TP23, TP25, TP26, TP27, TP28, TP29, TP31, TP32, TP33, TP34 | TPS127 |  |  |  |  |  | 1.27mm x 1.27mm PCB Copper Area (SMD Test Point) | SMD_PAD_1.27X1.27MM | 27
Test Point | Test Point | TP13, TP24 | NICOMATIC_C12000B | NICOMATIC | C12000B |  |  |  | SMD Test Point | NICOMATIC_C12000B | 2
1:2 | 50 Ohms 3 to 300MHz RF Transformer | TR1 | XFMR_MINI-CIRCUITS_DB714 | MINI-CIRCUITS | TCM2-1T |  |  |  | 50 Ohms 3 to 300MHz RF Transformer | XFMR_MINI-CIRCUITS_TCM2-1T | 1
1:1 | 50 Ohms 4.5 To 3000MHz RF Transformers | TR2 | XFMR_MINI-CIRCUITS_AT224 | MINI-CIRCUITS | TC1-1-13M+ |  |  |  | 50 Ohms 4.5 to 3000MHz RF Transformer | XFMR_MINI-CIRCUITS_TC1-1-13M+ | 1
1:1.5 | 50 Ohms 10 to 1800MHz RF Transformer | TR3, TR4 | XFMR_MINI-CIRCUITS_TT1618 | MINI-CIRCUITS | TRS1.5-182+ |  |  |  | 50 Ohms 10 to 1800MHz RF Transformer | XFMR_MINI-CIRCUITS_TRS1.5-182+ | 2
TC649EOA | PWM Fan Speed Controller with Auto-Shutdown and FanSense Technology, 8-Pin SOIC, Industrial Temperature | U1 | SOIC127P600X175-8N |  |  |  |  |  |  |  | 1
Custom 3D printed | SMA_Shoulder Washer | WASHER1, WASHER2 | Keystone_7687 | Custom 3D printed | Custom 3D printed |  |  |  | Polyphenylene Sulfide PPS Shoulder Washer | Custom 3D printed | 2
