sinara-hw/VHF_Amp/(threads)

Thread 1 (2023-03-22):

Simple 10W RF amplifier

gkasprow, 2023-03-22:
We need to build a 10MHz amplifier delivering 10W of power to drive the RF resonator, which will boost it to 500V or so.
The amplifier will be 6HP wide and work with EEM and DI/OT.
The initial specification:
- single channel (unlike SiLPA)
- 6 (DI/OT) compatible or 8 HP (EEM) wide
- Push-pull configuration using 2 MOSFETs (very popular within the SSB community)
- 10-100MHz or wider
- 10W output power in linear mode (let's say 2nd and 3rd harmonic <30dBc)
- Drive stage using either fast opamp or mini circuits gain block
- Must work with Urukul, gain ~40dB
- High linearity; the design will let the user choose high efficiency or high linearity mode by adjusting the bias current
- RF power detector for feedback (RF amplitude stabilisation)
- Basic diagnostics - current measurement for both output stage MOSFETs (symmetry is critical for linearity); output power measurement
- Overtemp protection (LM75)
- Fast output interlock, no directional coupler foreseen

Would you have any thoughts to share about it?

Thread 2 (2024-03-21):

design review

gkasprow, 2024-03-21:
- [ ] the power detector thresholds are free floating: DET_TRH_REV; DET_TRH_FWD; maybe add another MAX DAC
- [ ] the JK flip flop RSTn and CLK are shorted together on top entity which don't make much sense to me
- [ ] don't we need some manual reset button?
- [ ] won't T4 saturate due to slight output current imbalance?
- [ ] add LEDs: overtemp, FWD interlock,  REV interlock
- [ ] missing P3V3_CPCIS source
- [ ] there are a lot ERC and DRC errors
- [ ]

shanasz, 2024-04-01:
>  won't T4 saturate due to slight output current imbalance?
Core has Isat at least 7A, max current in Id of MRF101 in this application will be lower than 1A.
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

gkasprow, 2024-04-09:
- [ ] please add trimpots to adjust bias during board tests

gkasprow, 2024-04-12:
- [ ] Move the fine-tune input to the front panel, as in other designs like WENZEL_REF
- [ ] Make the reset button available from the front panel; use ordinary PB_TYCO_1-1825027-1
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
- [ ] Make sure the RF connectors are positioned as in newest Urukul - we want to re-use plastic distances
- [ ] Please add 3D model of the 6HP front panel (from Wenzel for example)
- [ ] please add 3D model of heatsink/shield
- [ ]  when adding series resistor to the ADC input, remember about storage capacitor (10nF or so) to the ground at the ADC input.
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
- [ ] FIN1028 has failsafe feature - with inputs unconnected, it will produce 3.3V at the output holeind DET_RST permanently high. Add P-MOSFET  in parallel to PB3 or inverter (like IC29)
- [ ] Where the power supply of IC29 is defined (VCC net) ? Add note on the schematic.
- [ ] put info about RF transformer ratios on the schematic
- [ ] IC33 will oscillate with ceramic caps, use 1..22u tantalum ones or add 100mOhm in series with C104

shanasz, 2024-04-14:
>  IC33 will oscillate with ceramic caps, use 1..22u tantalum ones or add 100mOhm in series with C104
Changed to LT1117

shanasz, 2024-04-14:
- [ ] correct ordered part list
- [ ] check debug connectors / testpoints for all test scenarios
- [ ] send 3D model changes (holdes for screwdriver for trimpots)

shanasz, 2024-04-14:
- [ ] correct PD placement
