sinara-hw/VHF_Amp/Modulator_v1_0_schematic.PDF

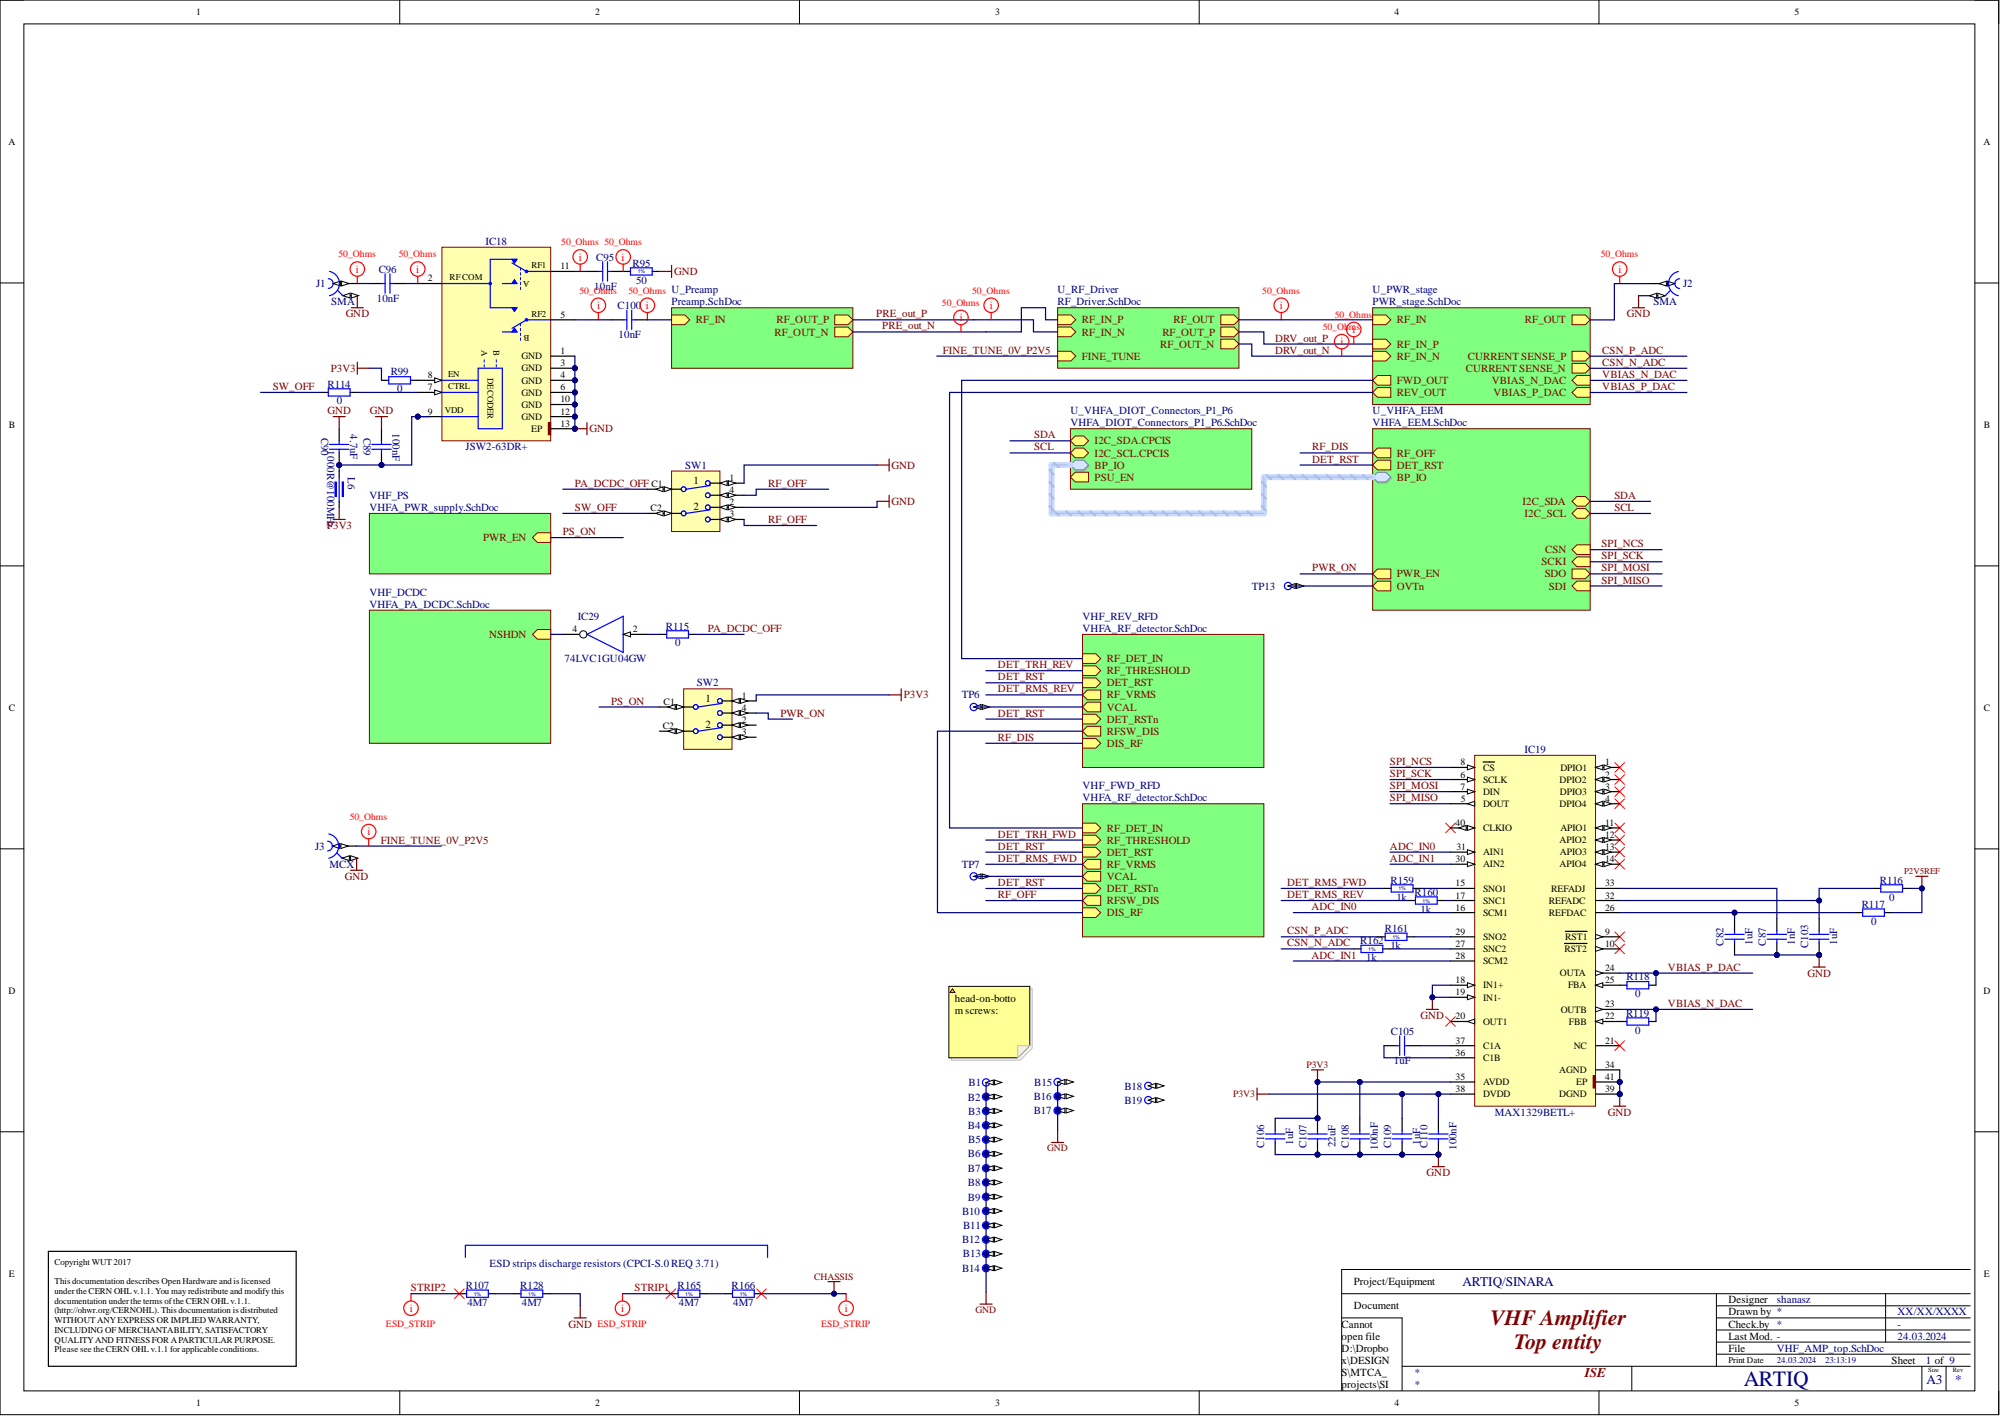
[picture p1: page 1]

1% | SNC2 27

ESD strips discharge resistors (CPCI-S.0 REQ 3.71)

This documentation describes Open Hardware and islicensed
under the CERN OHL v.1.1. You may redistribute and modify this
documentation under the terms of the CERN OHL v.1.1.
(http://ohwr.org/CERNOHL). This documentation is distributed
WITHOUT ANY EXPRESS OR IMPLIED WARRANTY,
INCLUDING OF MERCHANTABILITY, SATISFACTORY
QUALITYAND FITNESS FOR APARTICULAR PURPOSE.
Please see the CERN OHL v.1.1 for applicable conditions.

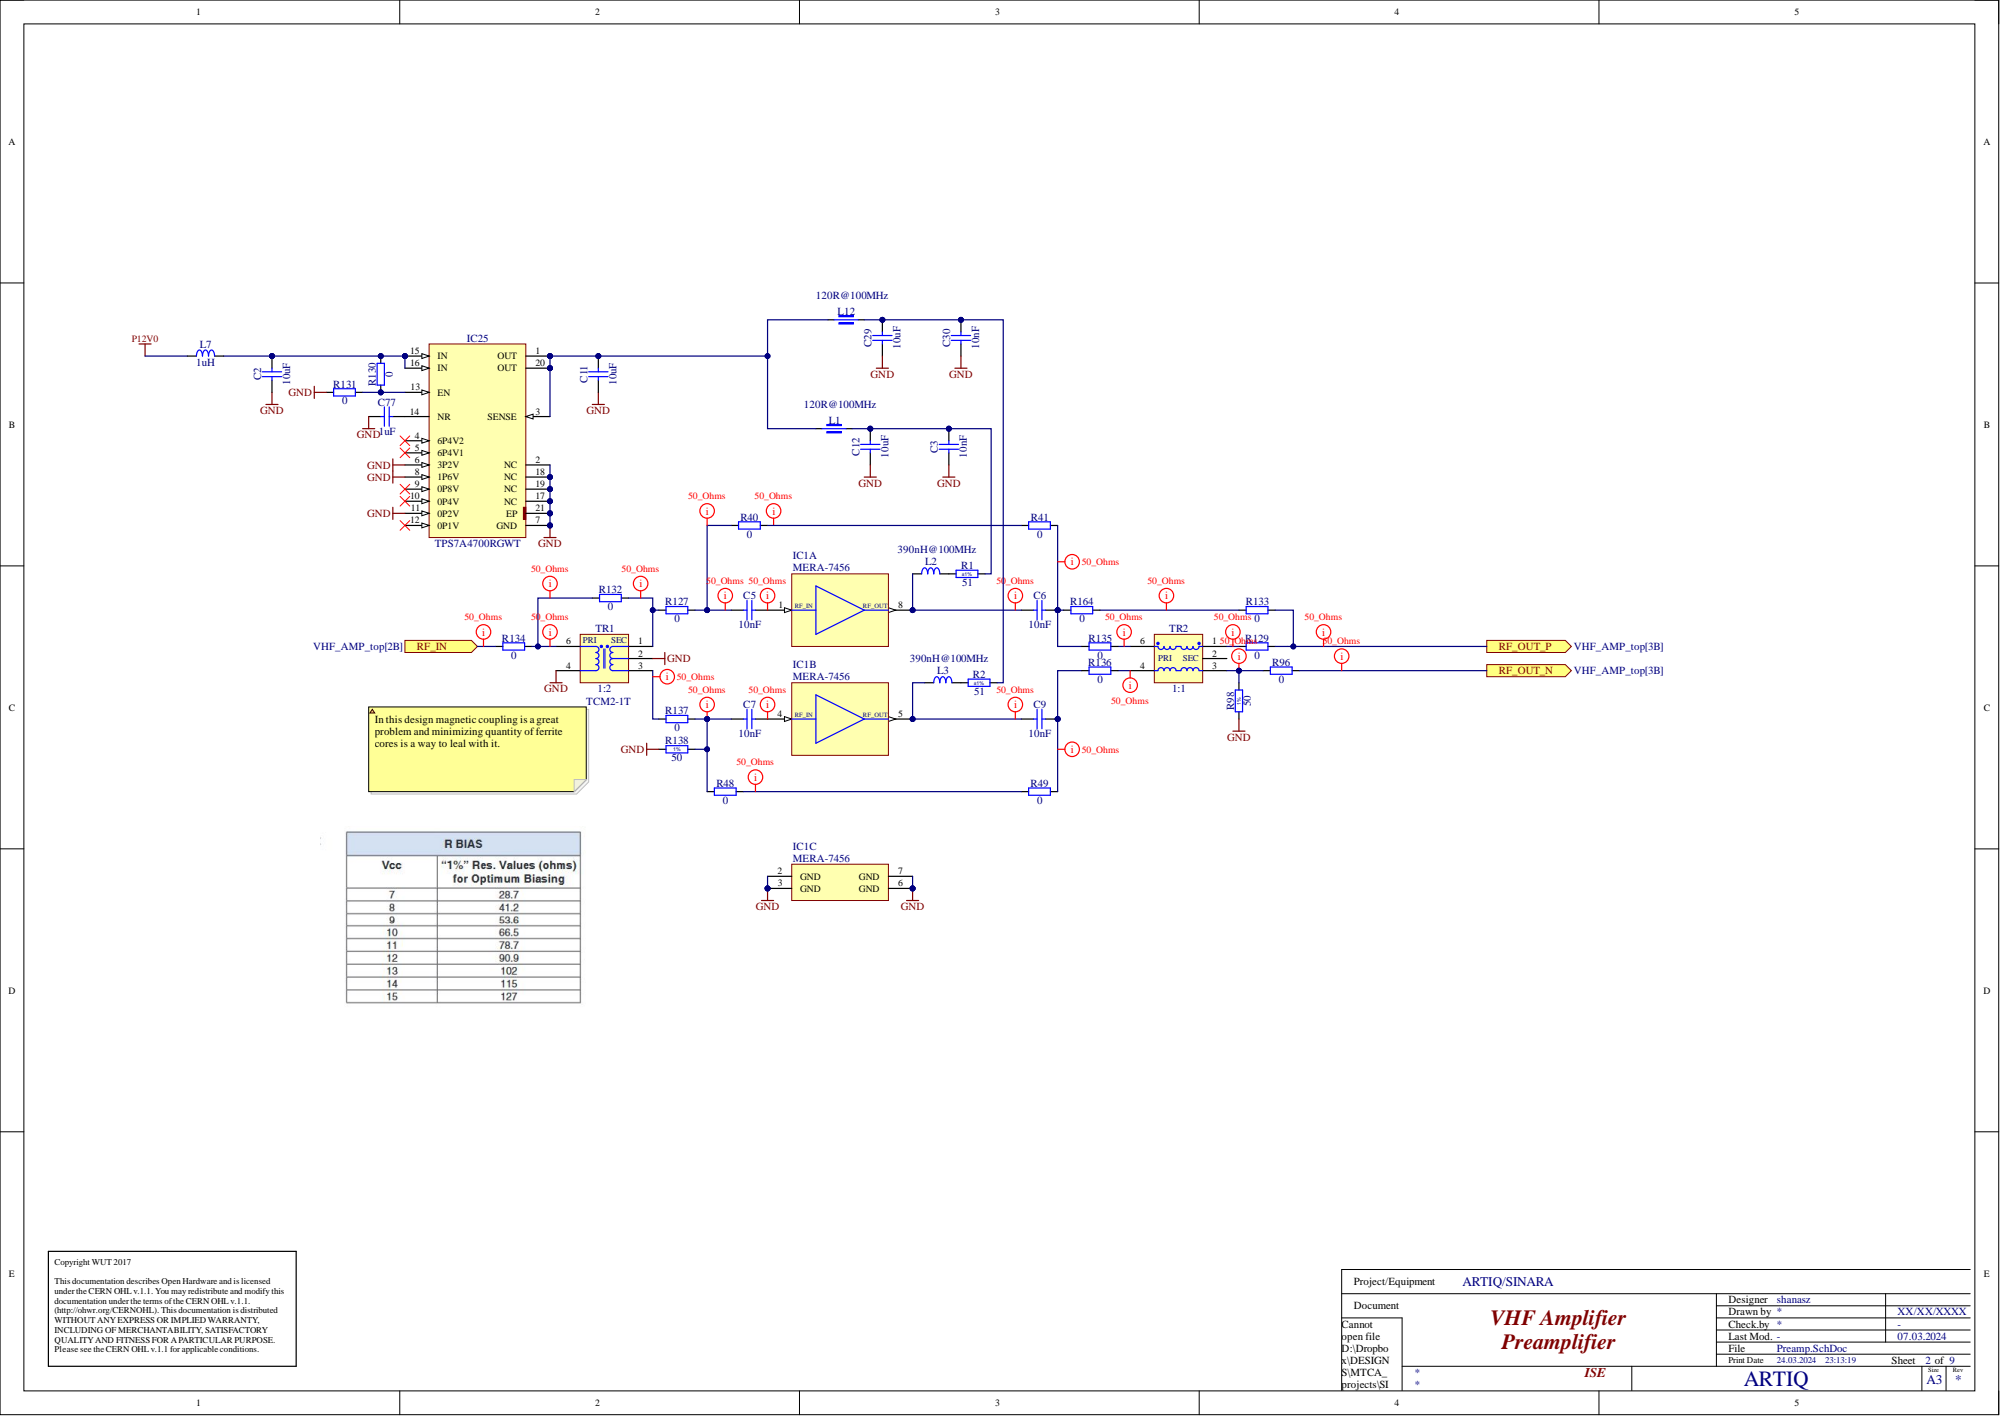
[picture p2: page 2]

i | 390nH@100MHz IC1A L2 R1

In this design magnetic coupling is a great
problem and minimizing quantity of ferrite
cores is a way to leal with it.

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

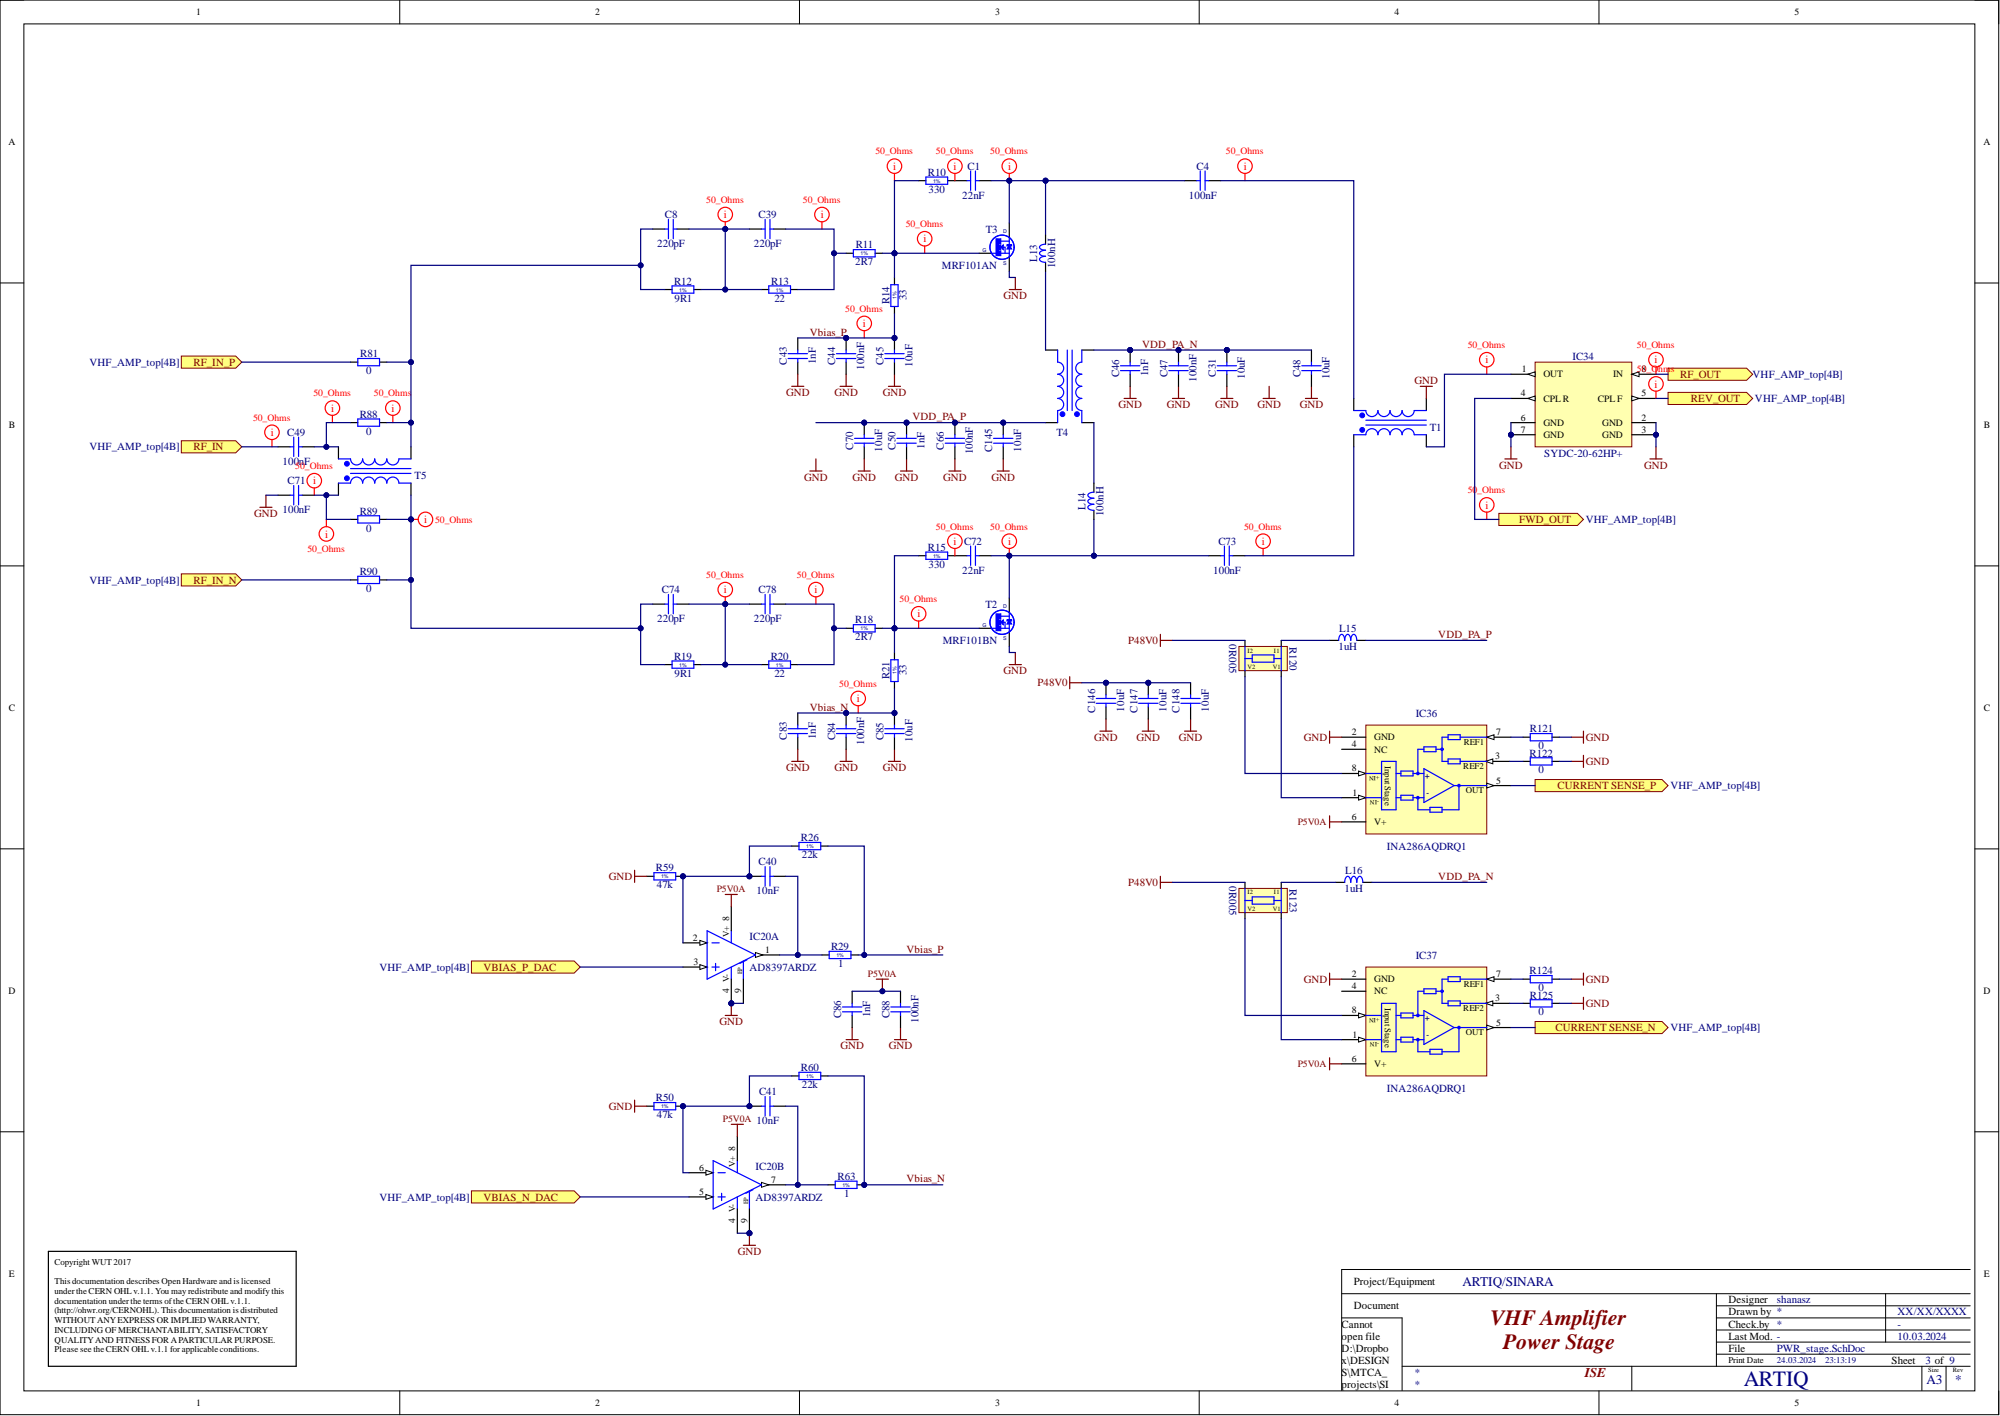
[picture p3: page 3]
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

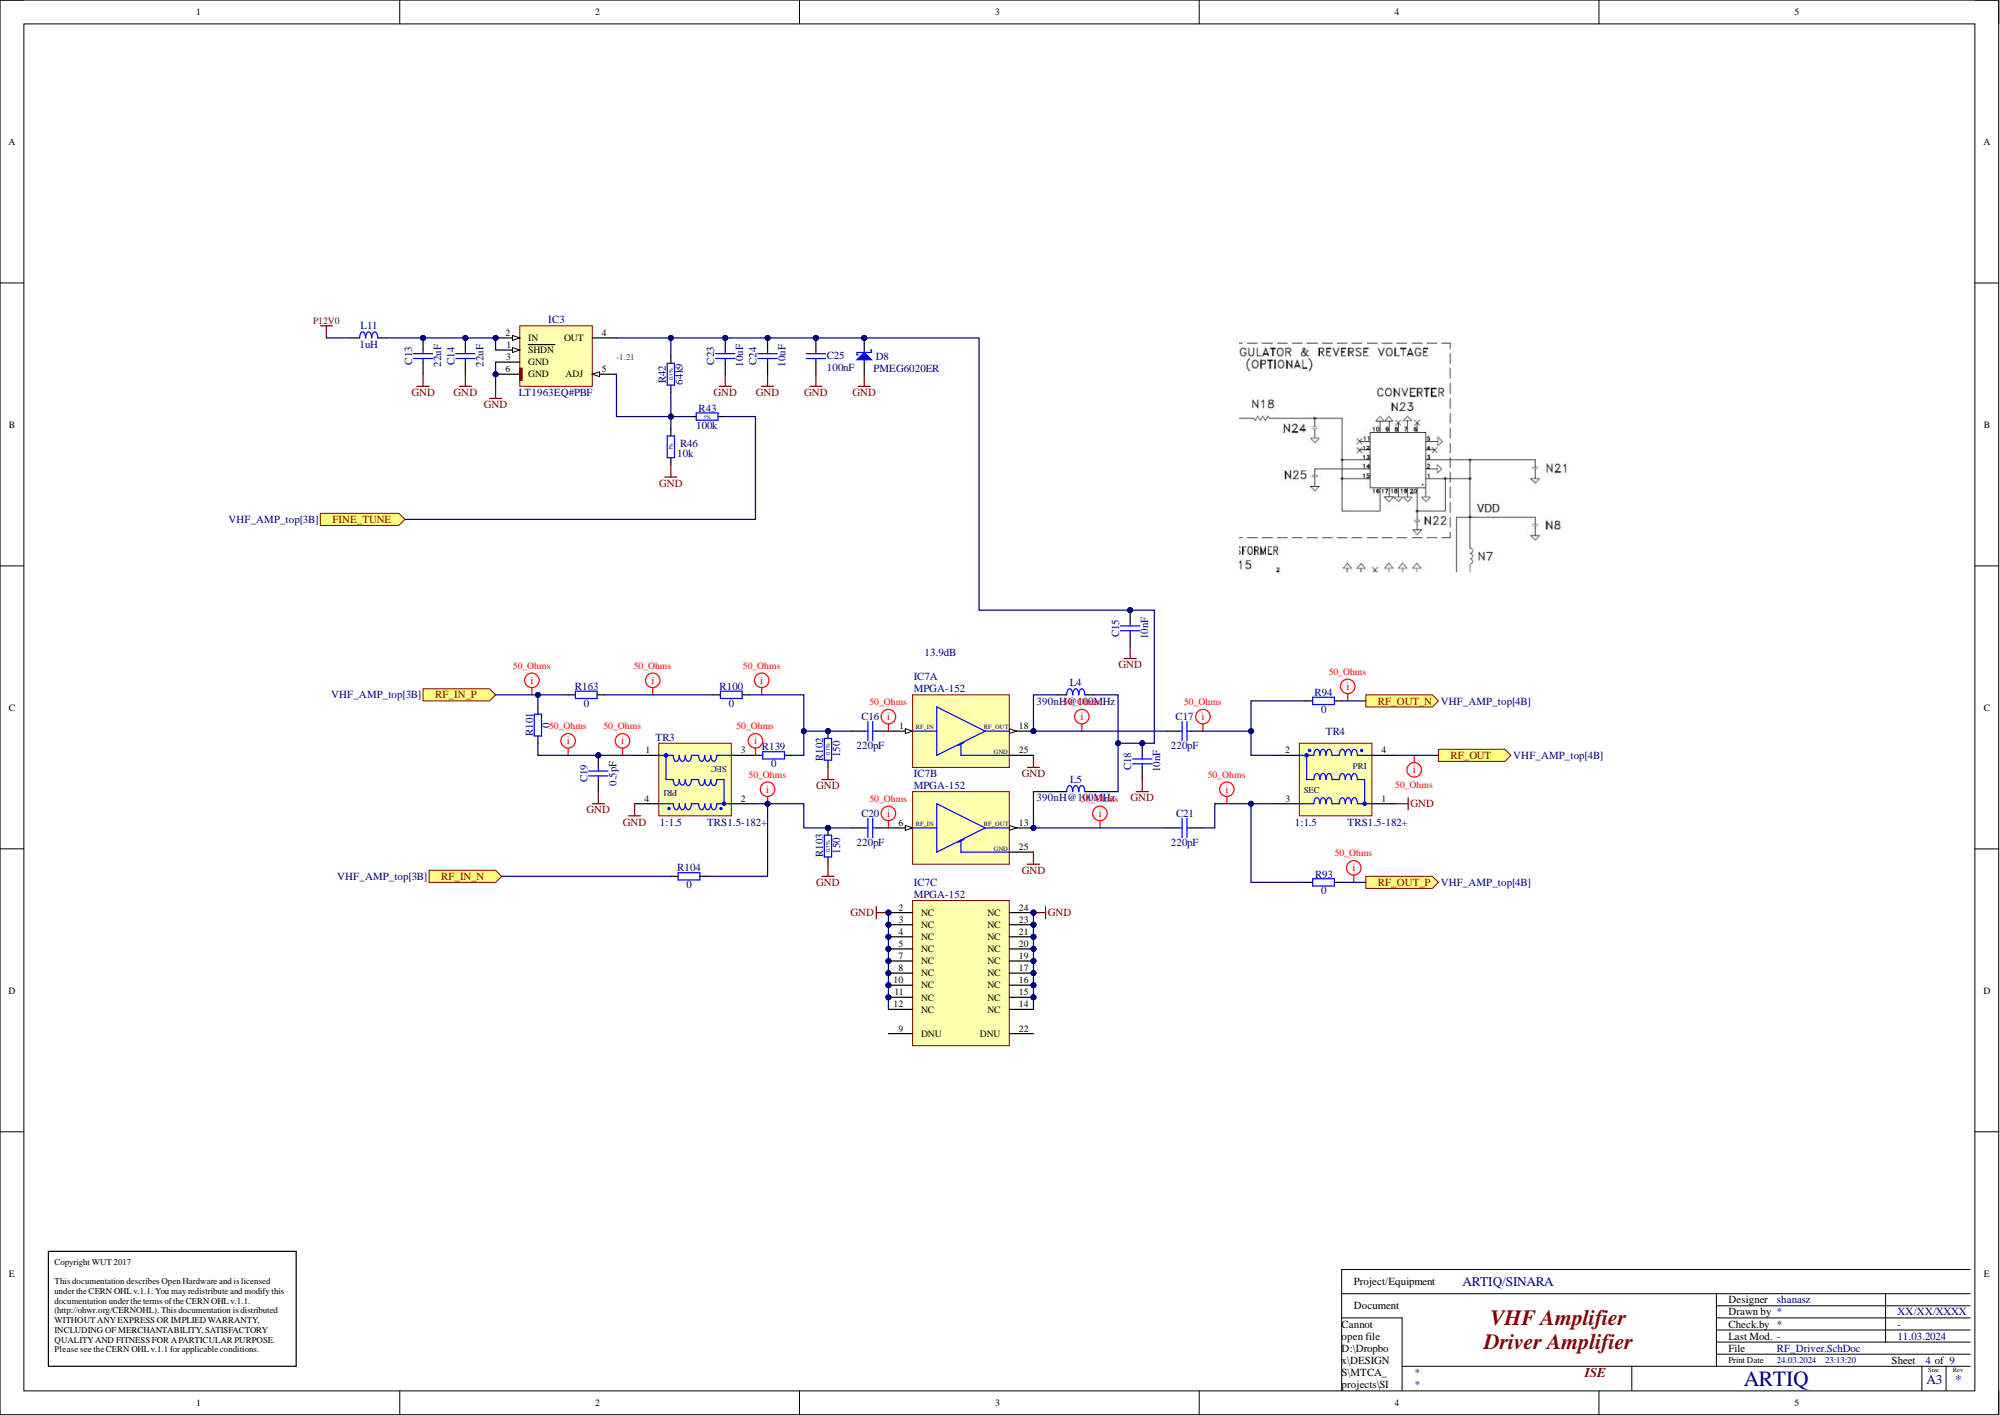
[picture p4: page 4]
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

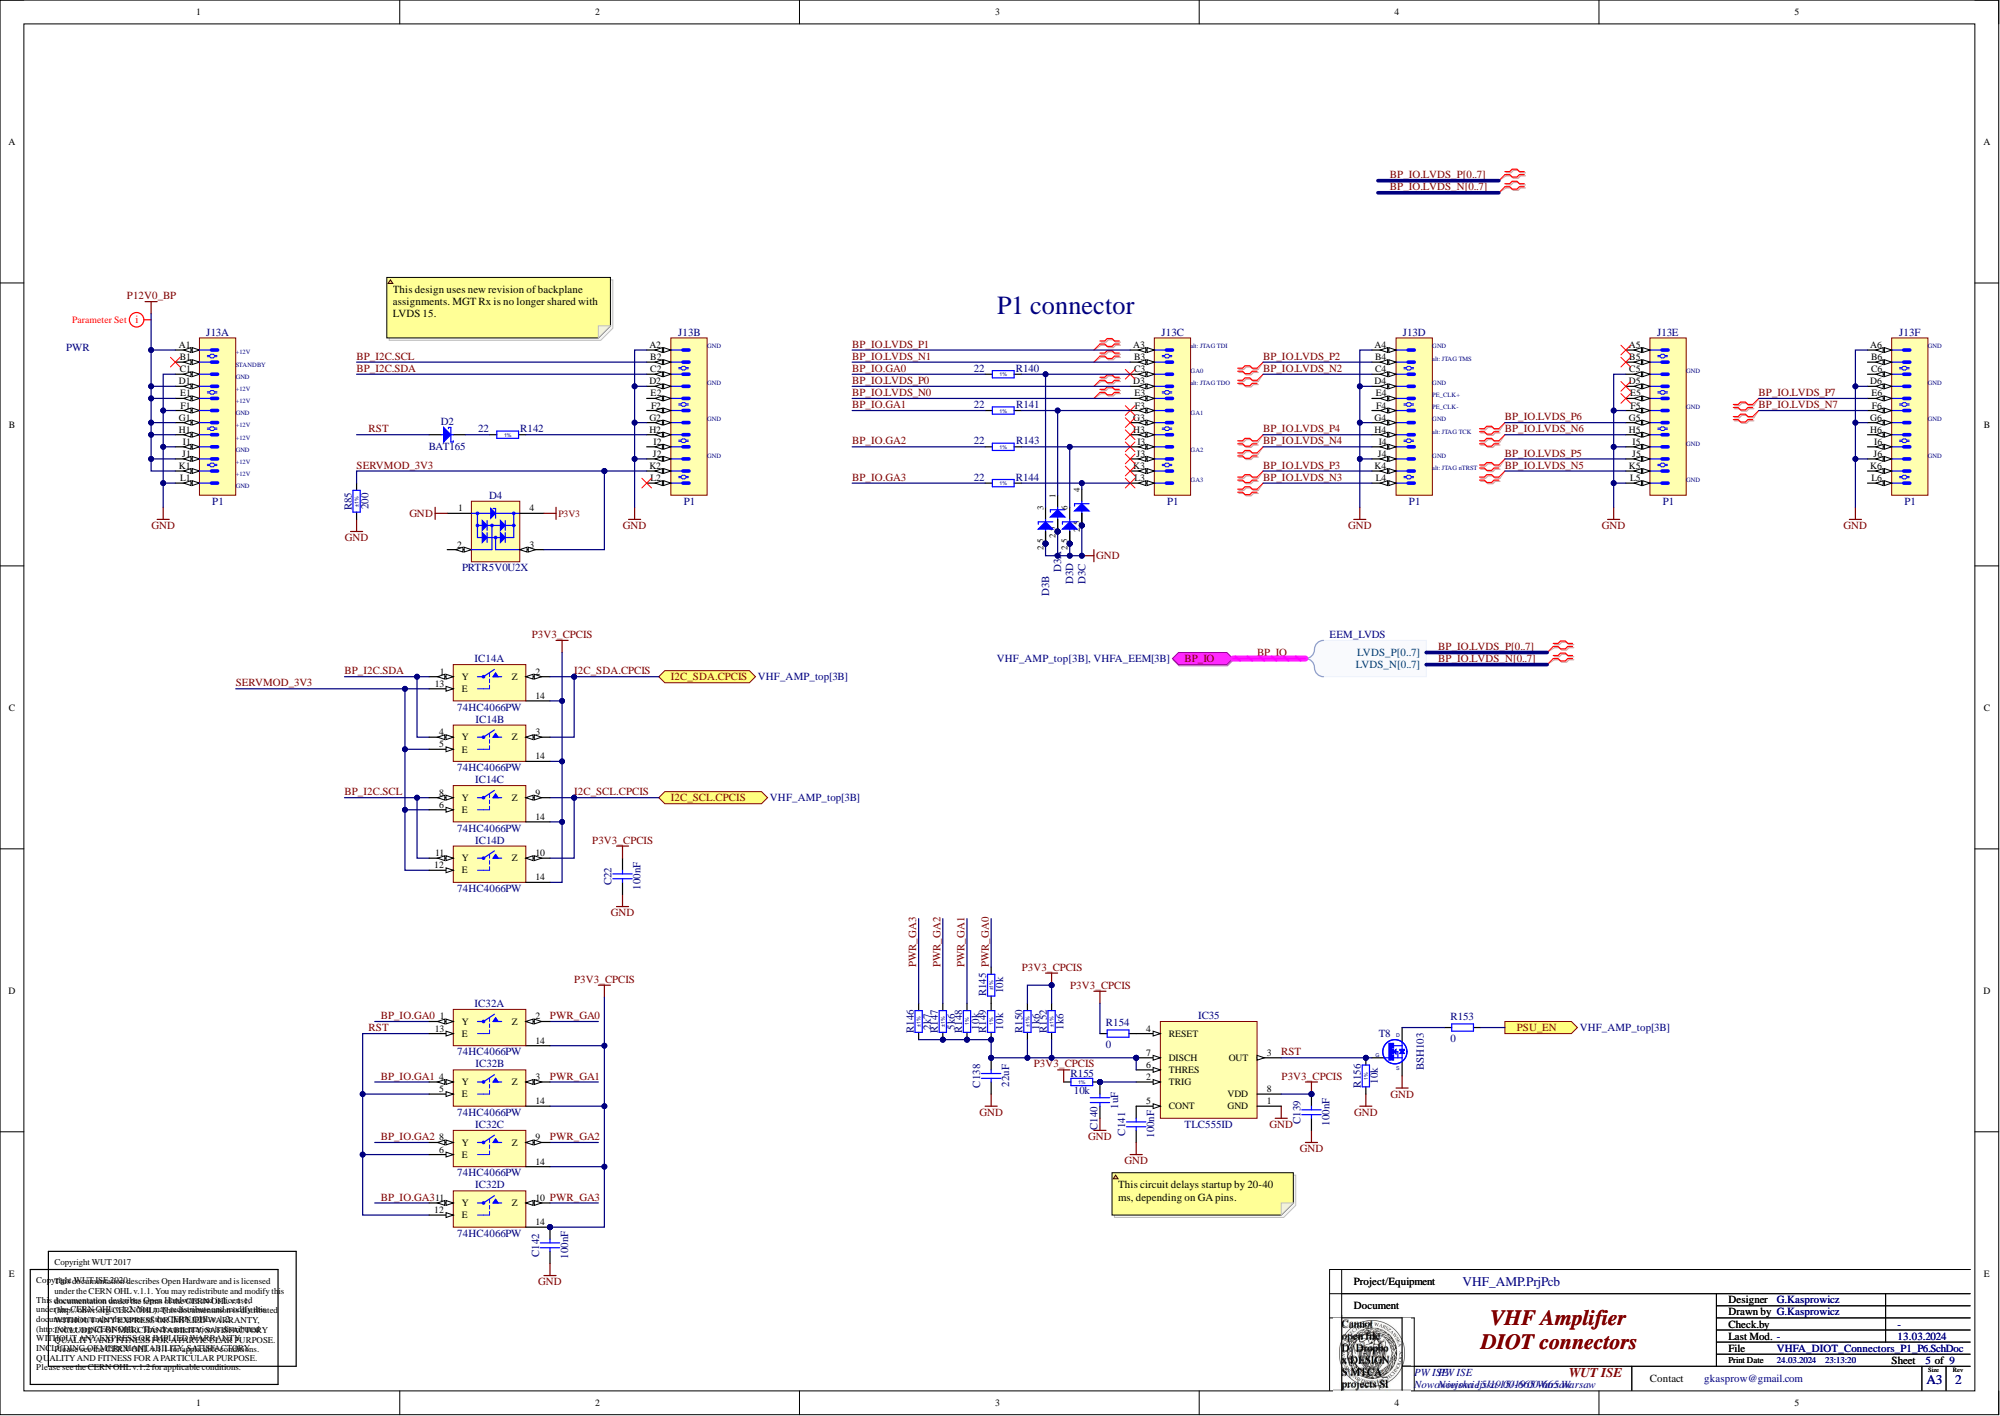
[picture p5: page 5]

This design uses new revision of backplane
assignments. MGT Rx is no longer shared with
LVDS 15.

1% | CONT 5

This circuit delays startup by 20-40
ms, depending on GA pins.

Copyright WUT ISE 2020.
This documentation describes Open Hardware and islicensed
under the CERN OHL v.1.1. You may redistribute and modify this
under the CERN OHL v.1.2. You may redistribute and modify this

Please see the CERN OHL v.1.2 for applicable conditions.

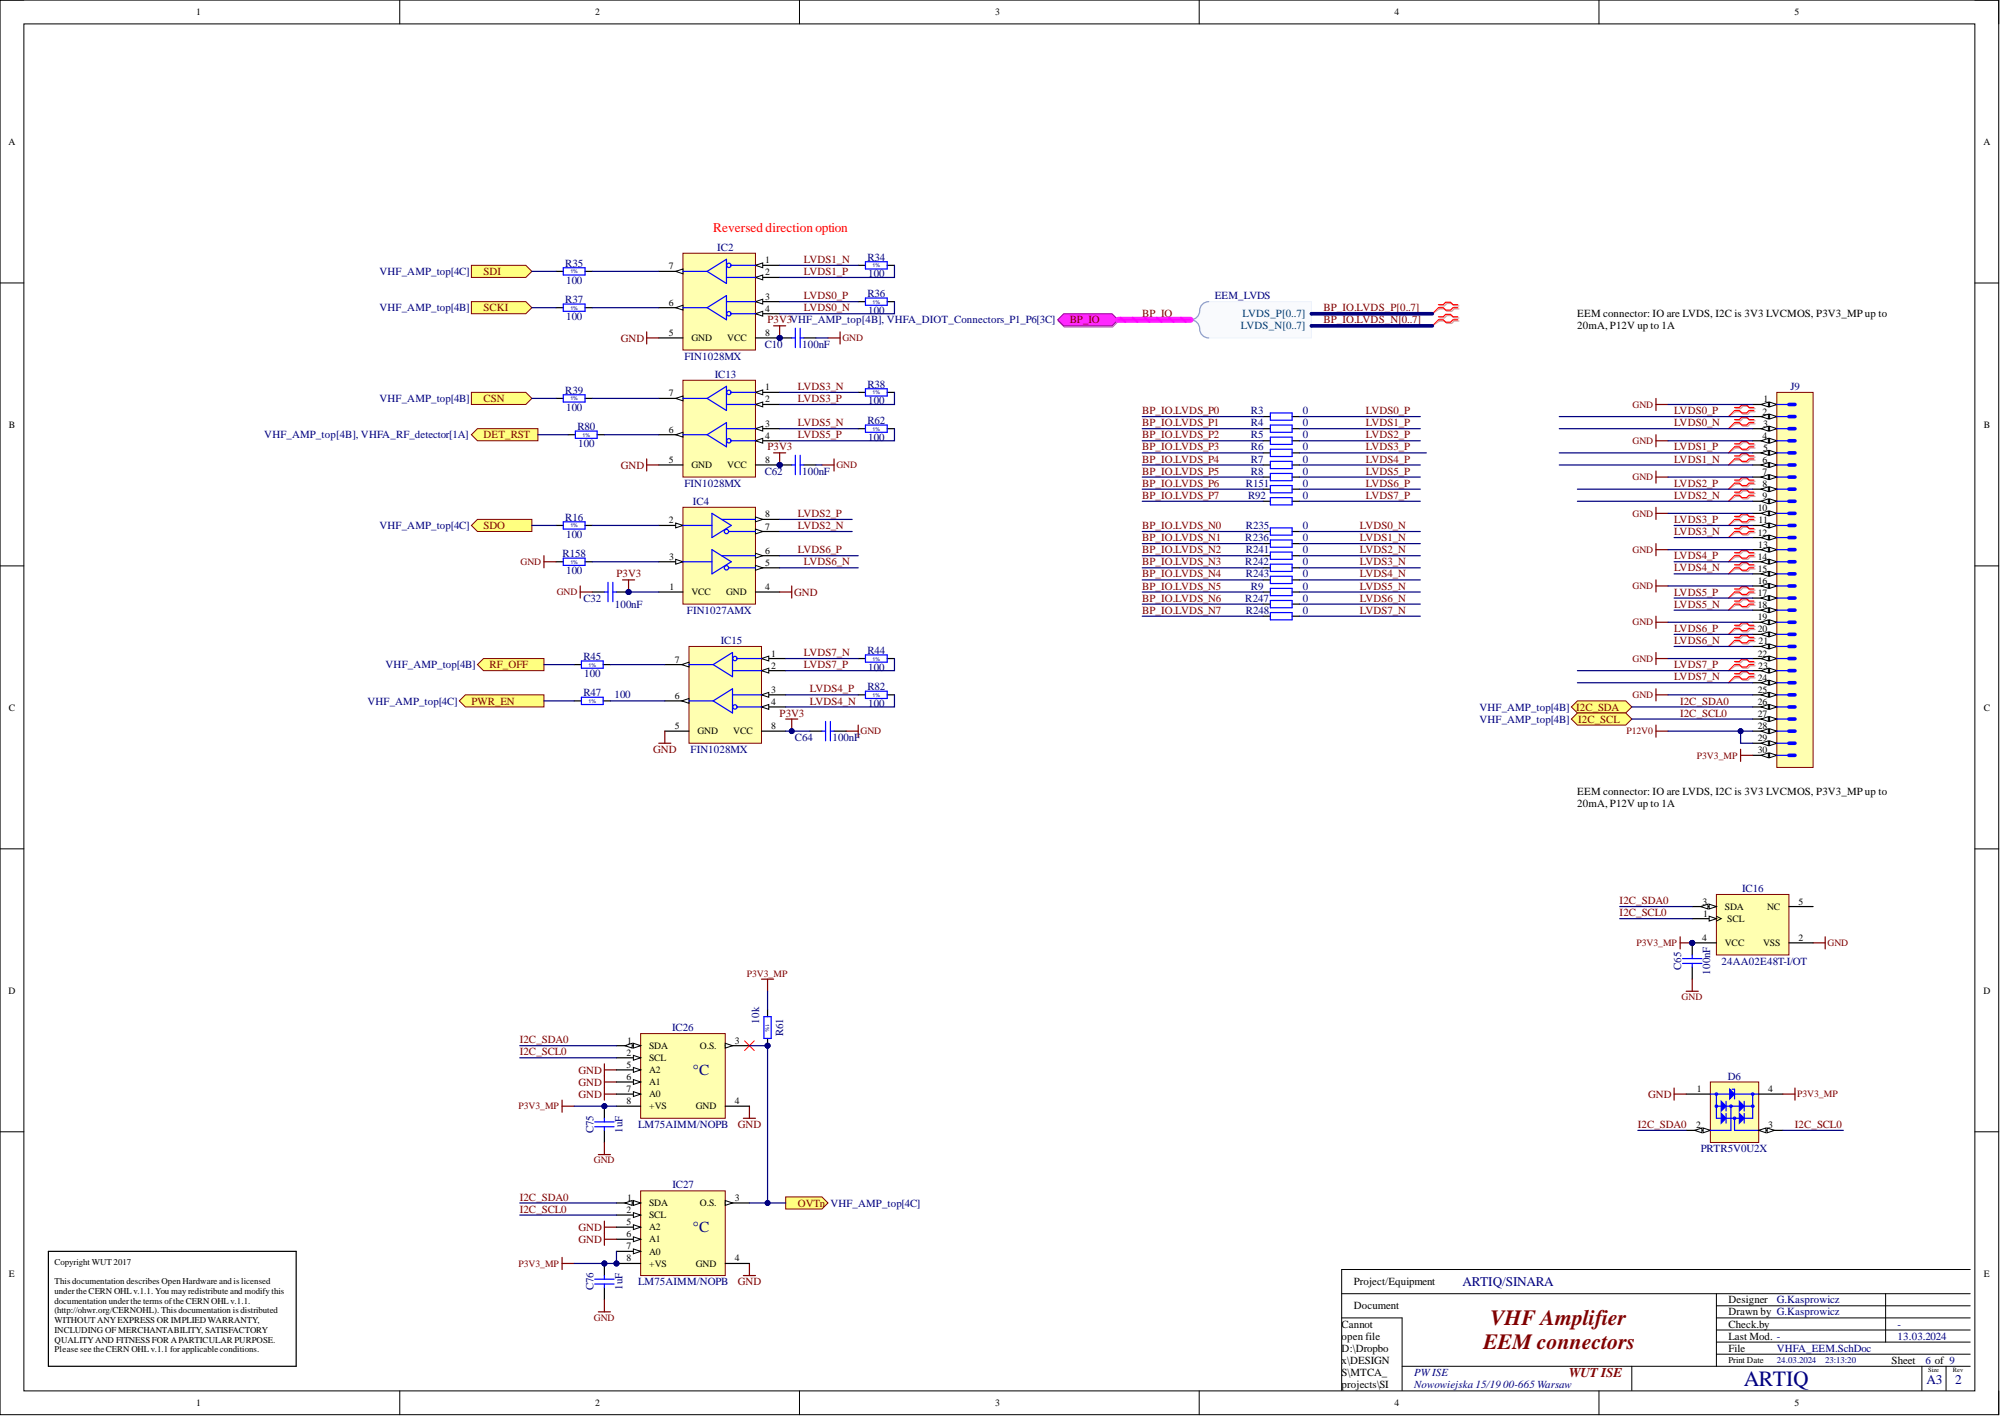
[picture p6: page 6]

EEM connector: IO are LVDS, I2C is 3V3 LVCMOS, P3V3_MP up to

LVDS5_P | 1% 100

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

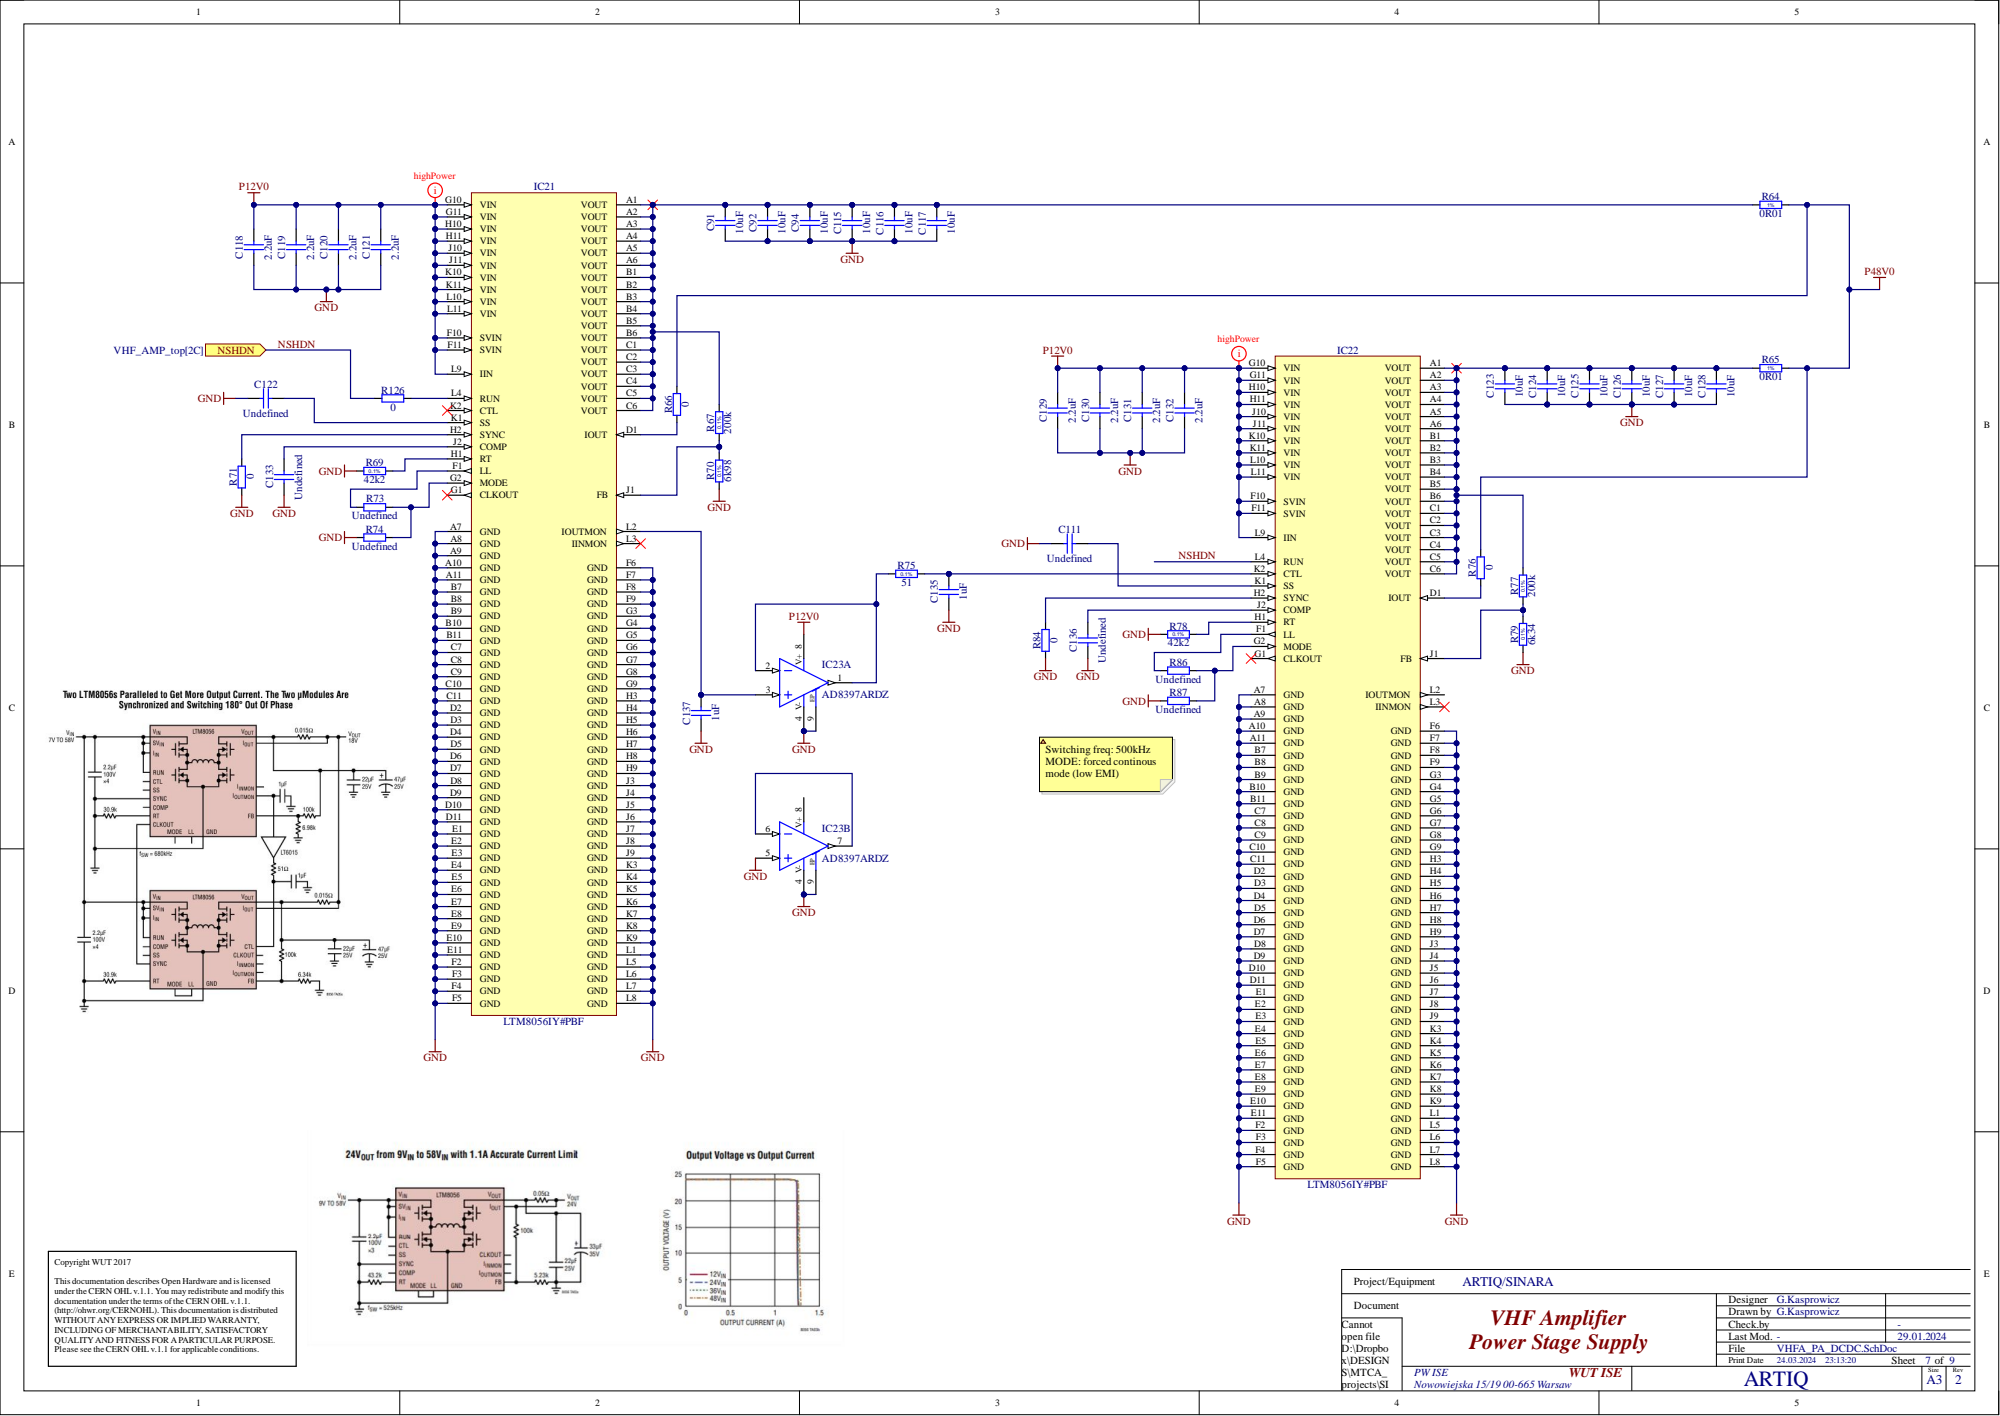
[picture p7: page 7]

VIN G11 | 1%

VIN L10
VIN L11

SVIN F10
SVIN F11

IIN L9

COMP J2
RT H1
LL F1

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

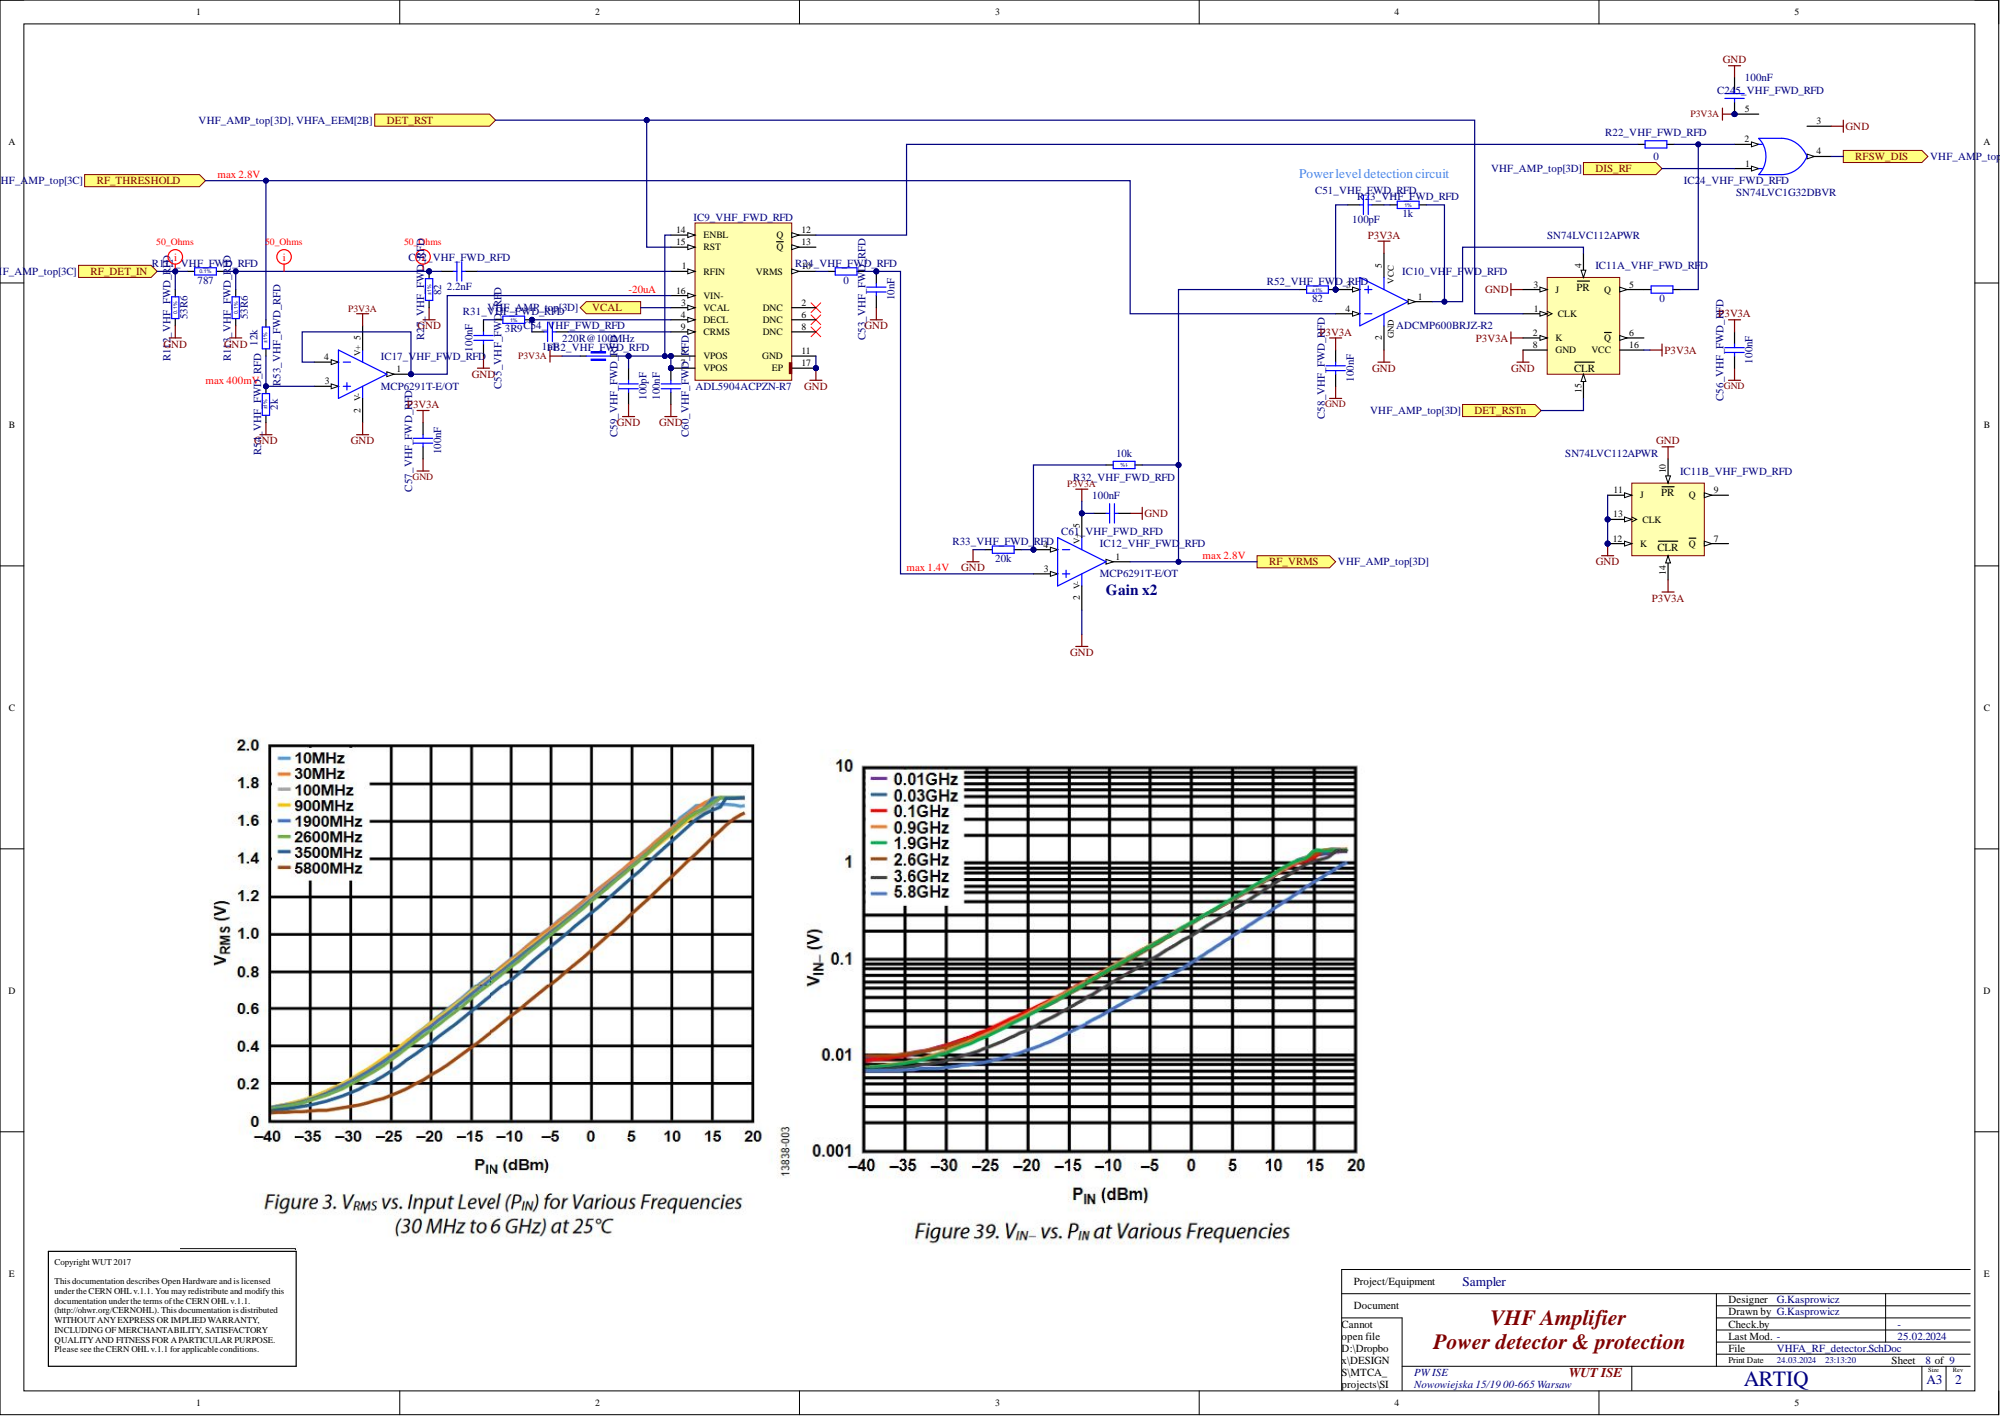
[picture p8: page 8]

Power level detection circuit
C51_VHF_FWD_RFD

1% | C54_VHF_FWD_RFD | DECL 4 DNC CRMS 9 DNC | 6 8 | GND max 1.4V | 10k | P3V3A | K 2

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

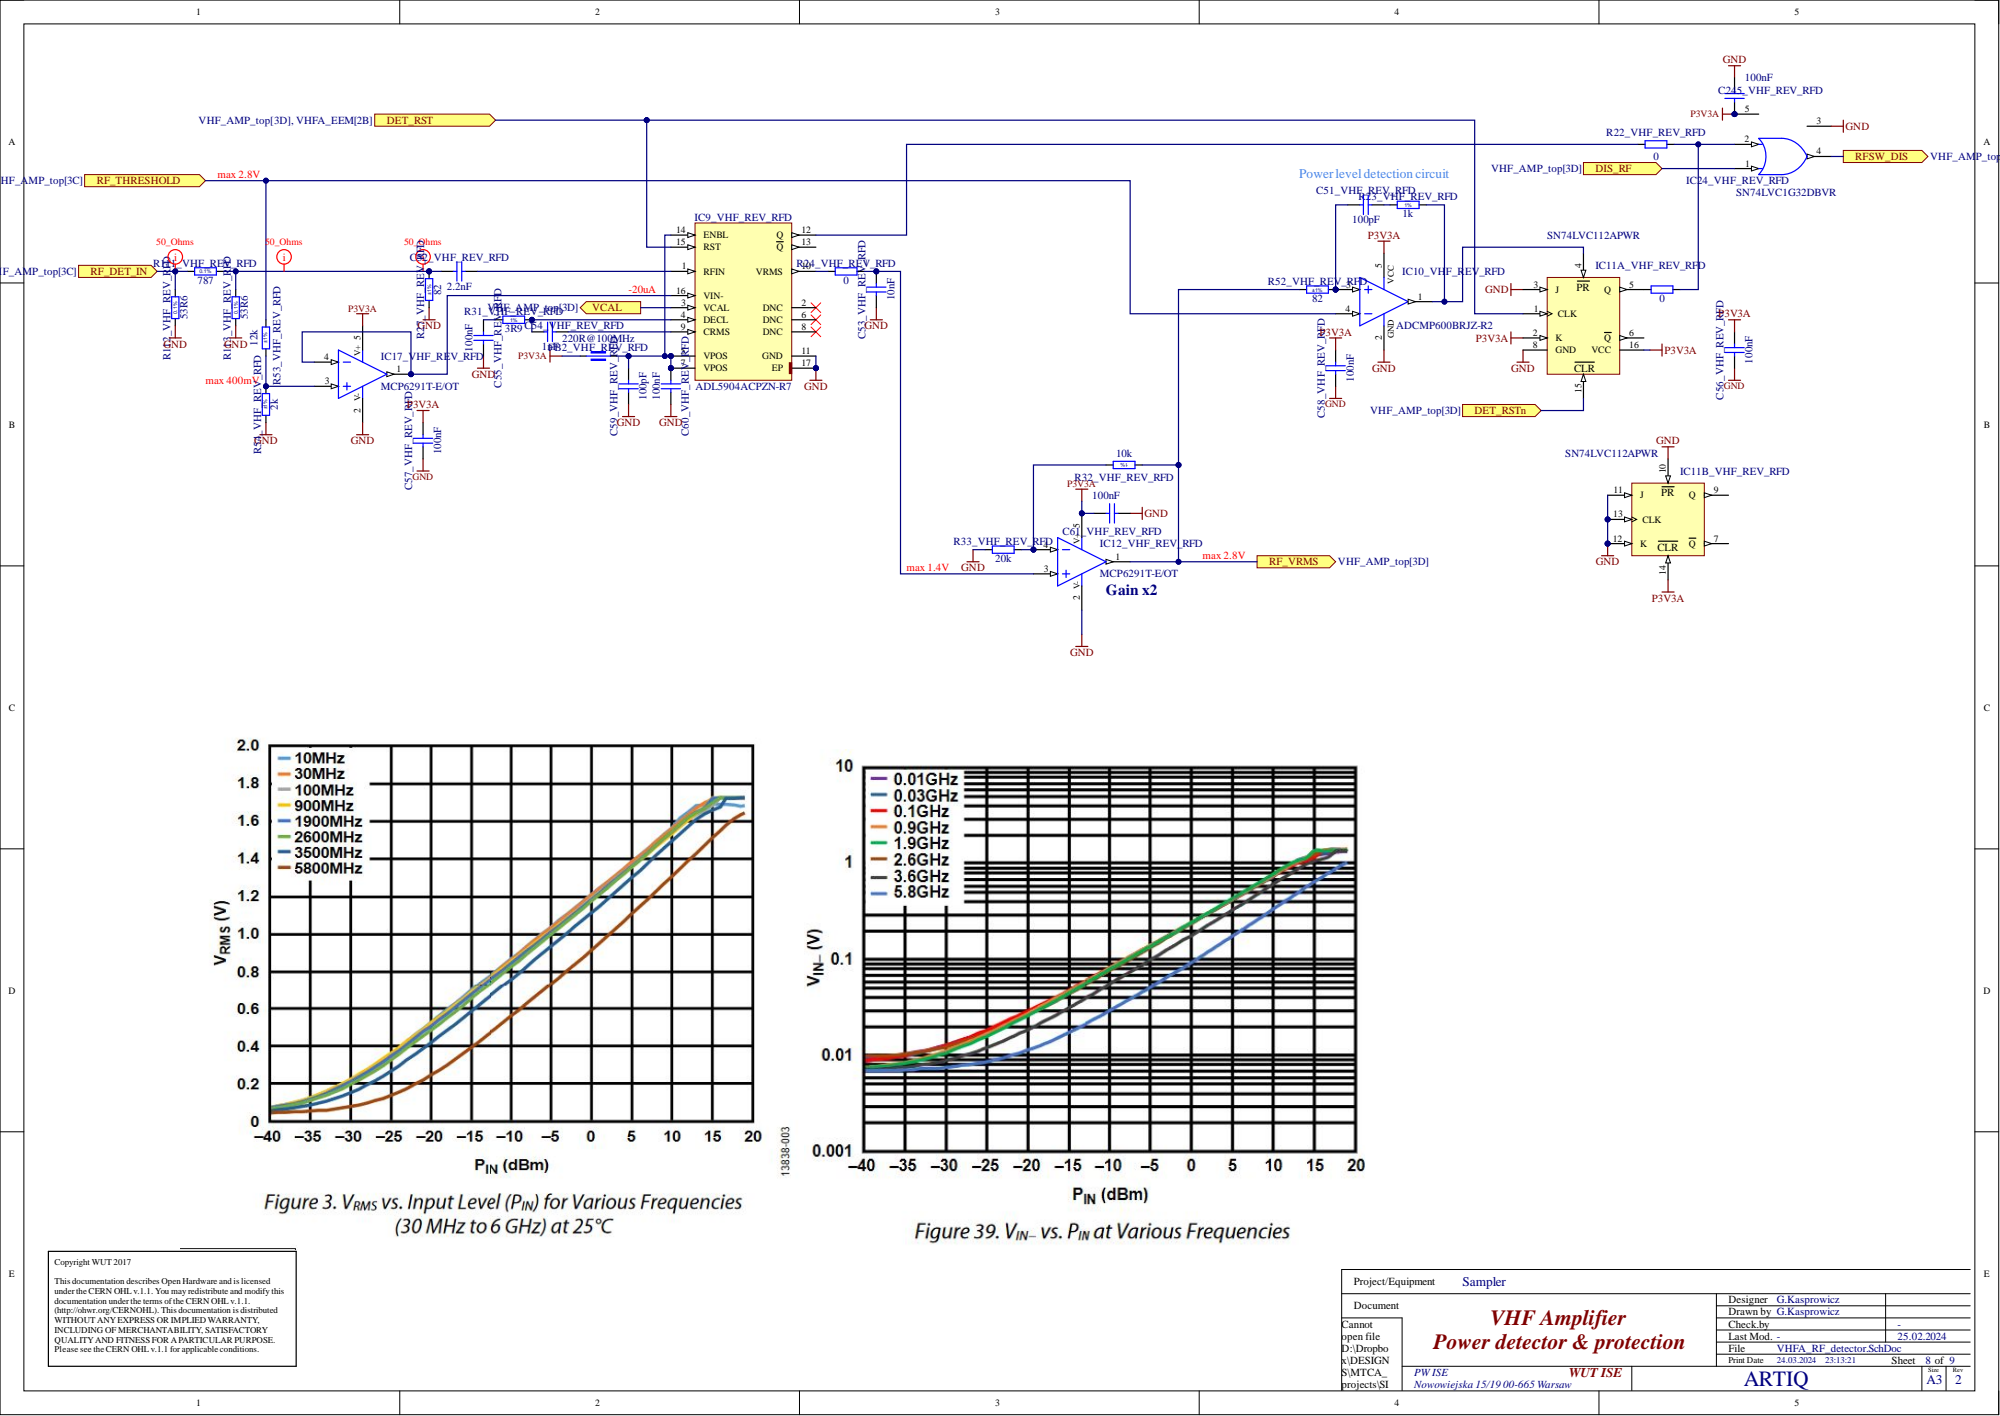
[picture p9: page 9]

Power level detection circuit
C51_VHF_REV_RFD

1% | C54_VHF_REV_RFD | DECL 4 DNC CRMS 9 DNC | 6 8 | max 1.4V | 10k | P3V3A | K 2

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

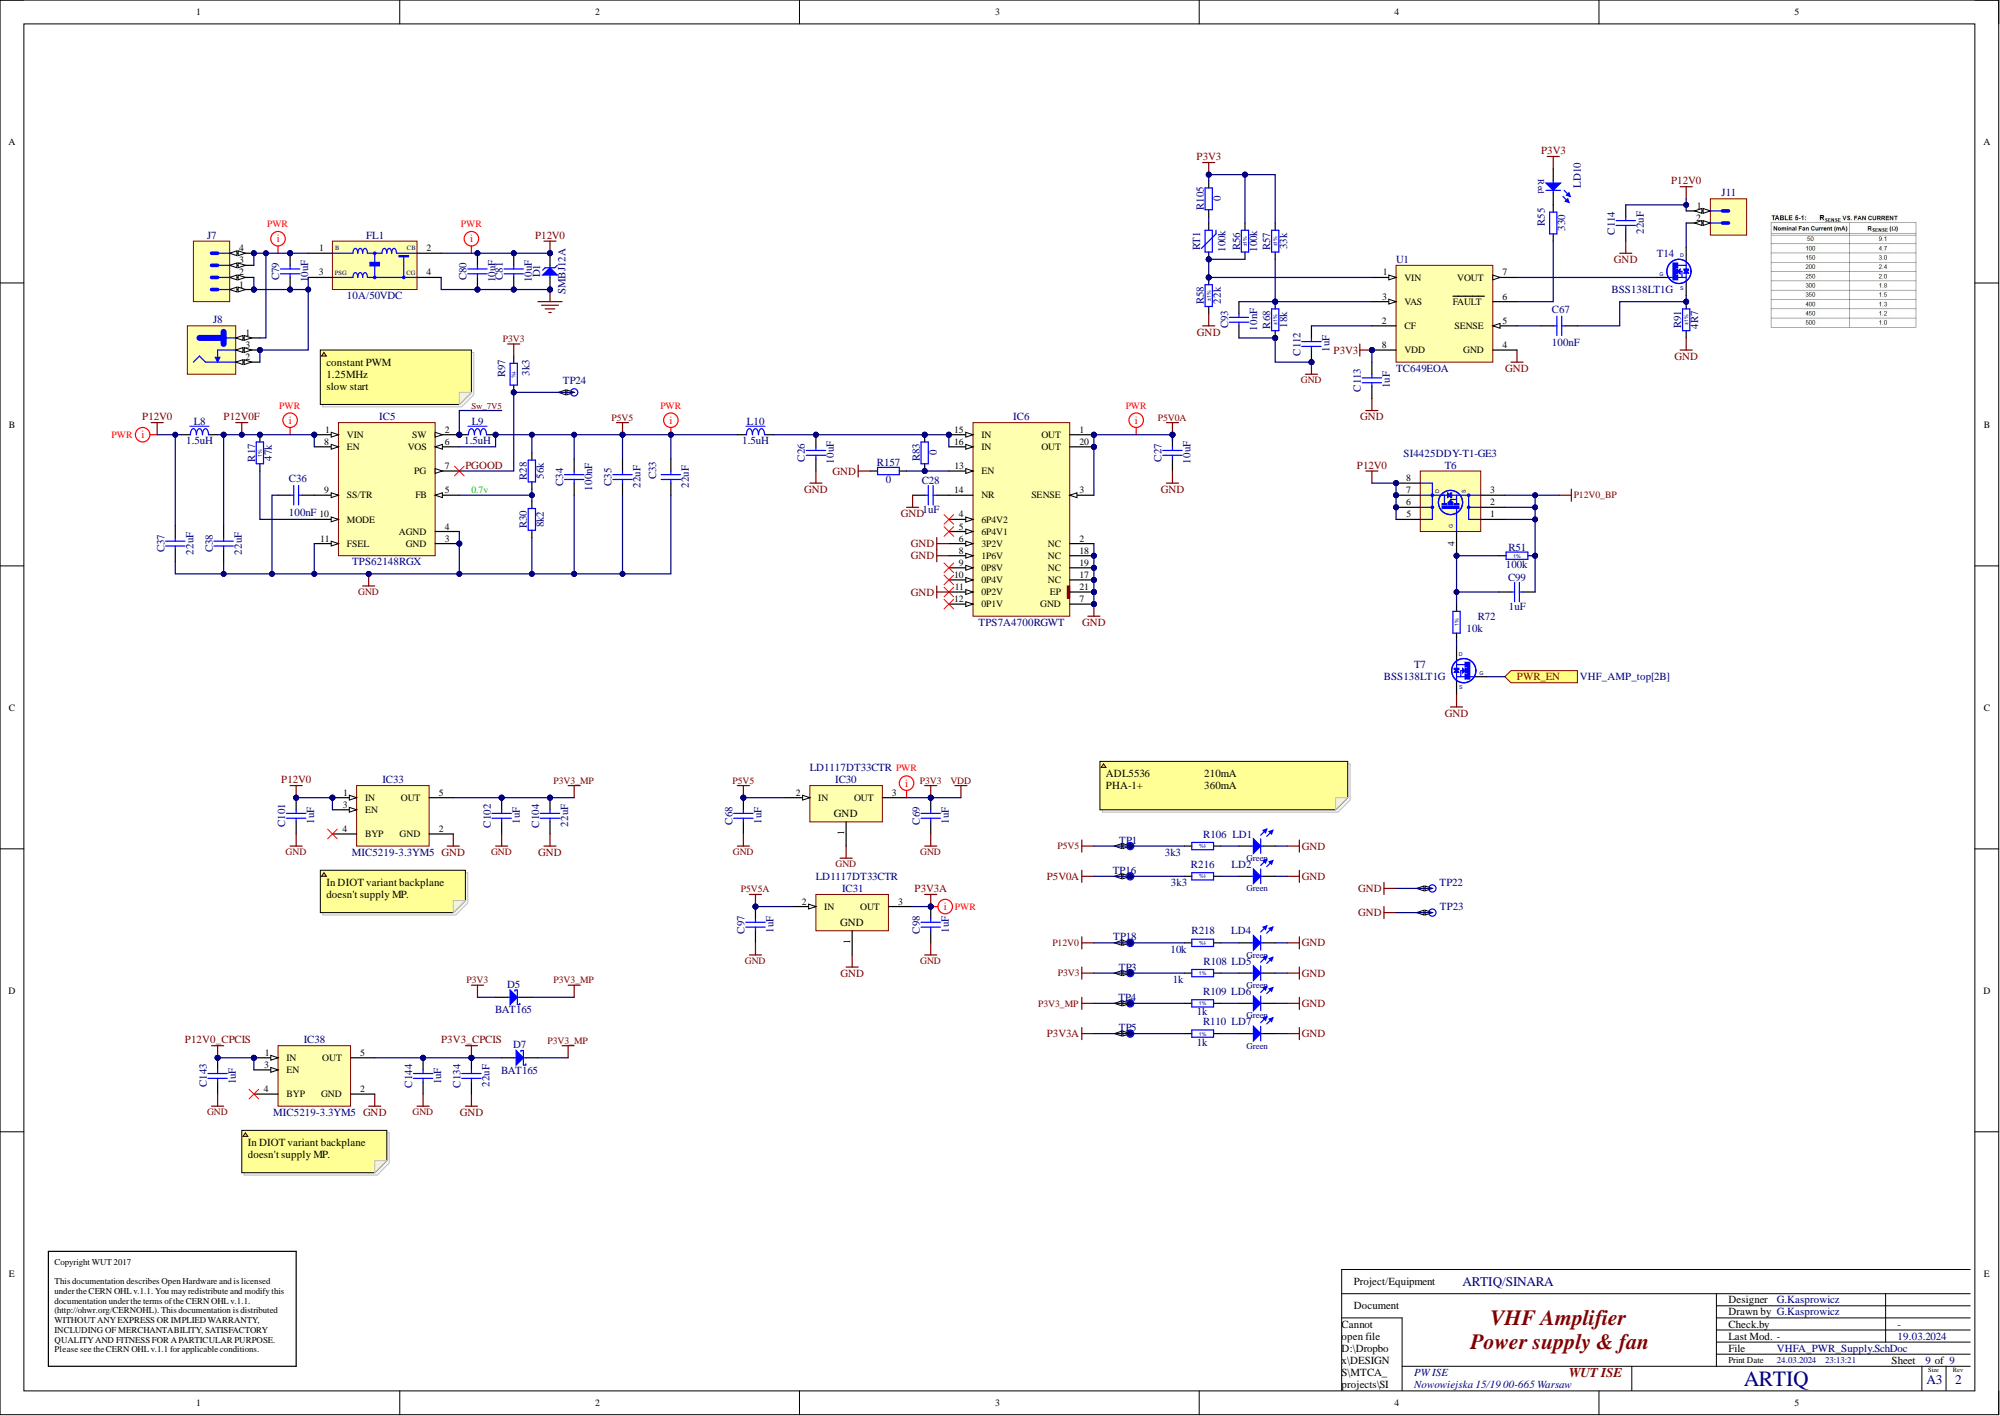
[picture p10: page 10]

In DIOT variant backplane
doesn't supply MP.

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
