sinara-hw/VHF_Amp/(list of files, drawings)

Other design files:
BIAS_control.SchDoc
Preamp.SchDoc
PWR_stage.SchDoc
RF_Driver.SchDoc
Supply_Modulator.SchDoc
VHF_AMP.PCBDOC
VHF_AMP.PrjPcb
VHF_AMP_lib.PcbLib
VHF_AMP_lib.SchLib
VHF_AMP_top.SchDoc
VHFA_DIOT_Connectors_P1_P6.SchDoc
VHFA_EEM.SchDoc
VHFA_PA_DCDC.SchDoc
VHFA_PWR_Supply.SchDoc
VHFA_RF_detector.SchDoc
