sinara-hw/VHF_Amp/(commit log)

2024-01-03 placement finished, heatsink footprint added - to be modified
    [PWR_stage.SchDoc, Preamp.SchDoc, RF_Driver.SchDoc, Supply_Modulator.SchDoc, VHFA_DIOT_Connectors_P1_P6.SchDoc, VHFA_EEM.SchDoc, VHFA_PA_DCDC.SchDoc, VHFA_PWR_Supply.SchDoc]
2024-01-03 forgotten files
    [VHF_AMP.PrjPcb]
2024-01-04 rules modified
    [PWR_stage.SchDoc, Preamp.SchDoc, RF_Driver.SchDoc, VHFA_RF_detector.SchDoc, VHF_AMP.PrjPcb, VHF_AMP_top.SchDoc]
2024-03-15 stitching and corrections in routing left tbd
    [PWR_stage.SchDoc, Preamp.SchDoc, RF_Driver.SchDoc, VHFA_DIOT_Connectors_P1_P6.SchDoc, VHFA_EEM.SchDoc, VHFA_PA_DCDC.SchDoc, VHFA_PWR_Supply.SchDoc, VHFA_RF_detector.SchDoc]
2024-03-25 DRC clean, output files added. Ready for review.
    [Bill of Materials-VHF_AMP(std).xlsx, VHFA_PWR_Supply.SchDoc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]
2024-03-26 unavailable components (switches, L14, L15) changed. Power on reorganized.
    [PWR_stage.SchDoc, VHFA_DIOT_Connectors_P1_P6.SchDoc, VHFA_PWR_Supply.SchDoc, VHFA_RF_detector.SchDoc, VHF_AMP_top.SchDoc]
2024-03-28 Power supply (3v3_mp, cpsis) corrected
    [Preamp.SchDoc, RF_Driver.SchDoc, VHFA_DIOT_Connectors_P1_P6.SchDoc, VHFA_EEM.SchDoc, VHFA_PA_DCDC.SchDoc, VHFA_PWR_Supply.SchDoc, VHF_AMP_top.SchDoc]
2024-04-11 GKA remarks implemented
    [PWR_stage.SchDoc, VHFA_EEM.SchDoc, VHFA_PWR_Supply.SchDoc, VHFA_RF_detector.SchDoc, VHF_AMP_top.SchDoc]
2024-04-16 correct v1.1
    [VHF_AMP.PrjPcb]
2024-04-24 Corrected routing due to EC remarks, no placement (or other) change
    [Bill of Materials-VHF_AMP(std).xlsx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]
